ricardoalcaraz/TheJerrys/README.md

# The Jerrys Micromouse Team
*******************************************
Code for solving 16x16 maze using floodfill algorithm on Tensilica architecture.
