ricardoalcaraz/TheJerrys/(list of files, drawings)

Other design files:
altium_v4/altium_v4.PrjPCB
altium_v4/Communications.SchDoc
altium_v4/MCU.SchDoc
altium_v4/Micromouse_Altium_v4.PcbDoc
altium_v4/Micromouse_Altium_v4.SchDoc
altium_v4/Motors.SchDoc
altium_v4/Power.SchDoc
altium_v4/Sensors.SchDoc
