ricardoalcaraz/TheJerrys/eagle_v1/micromouse_v35.brd

## EAGLE design eagle_v1/micromouse_v35.brd (2017-06-12, an earlier design)

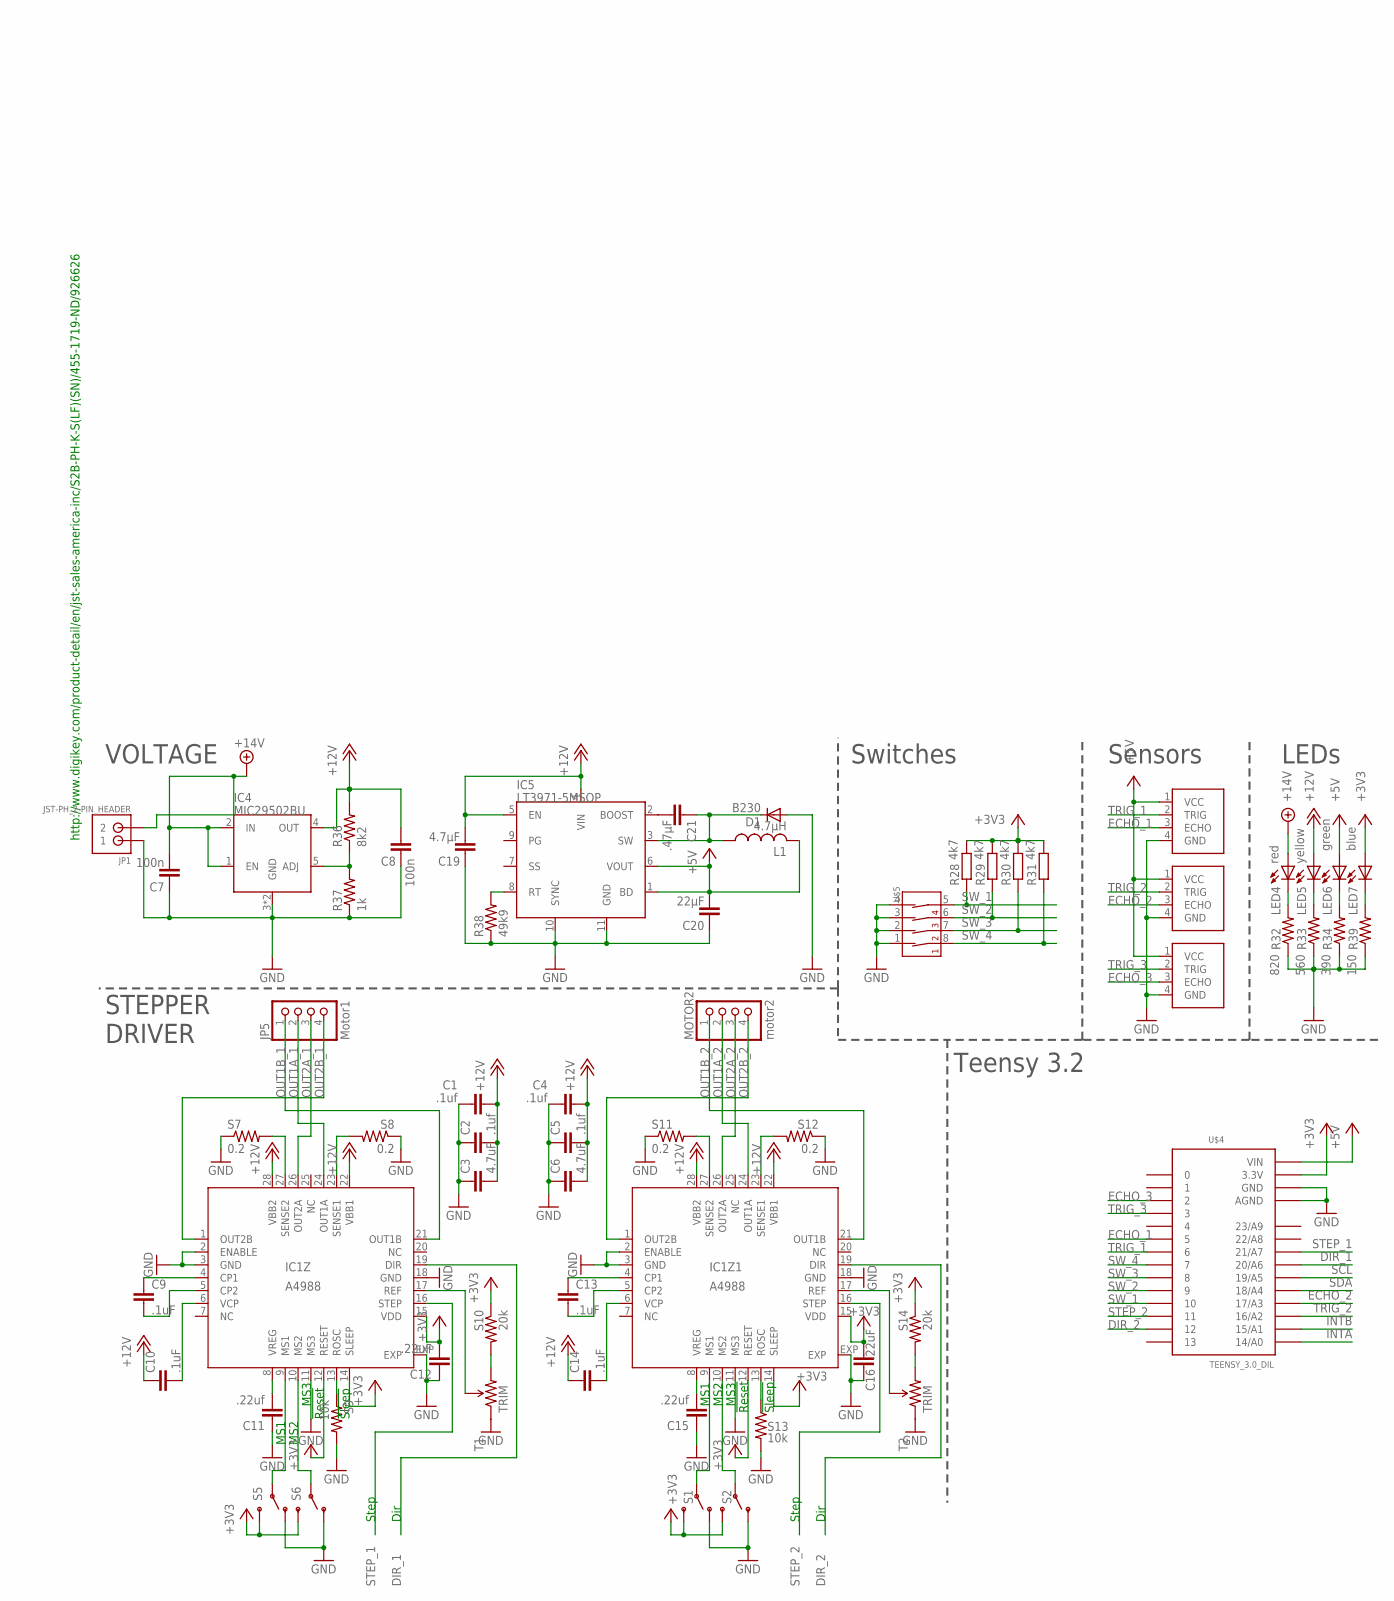
[picture p1: schematic micromouse_v35.sch]

Parts:
C1, C2, C4, C5: .1uf; C0603
C3, C6: 4.7uF; 1206
C7, C8: 100n; C0603
C9, C10, C13, C14: .1uF; C0603
C11, C15: .22uf; C0603
C12, C16: .22uF; C0603
C19: 4.7µF; C0603
C20: 22µF; C0805
C21: .47µF; C0603
D1: B230; DO-214AC
IC1Z, IC1Z1: A4988; QFN28ET
IC4: MIC29502BU; TO-263-5
IC5: LT3971-5MSOP; MSOP-10
JP1: JST-PH_2-PIN_HEADER; JST_B2B-PH_HEADER
JP5: Motor1; 1X04
L1: 4.7µH; L1812
LED4: red; SML0603
LED5: yellow; SML0603
LED6: green; SML0603
LED7: blue; SML0603
MOTOR2: motor2; 1X04
R28, R29, R30, R31: 4k7; R0603
R32: 820; R0603
R33: 560; R0603
R34: 390; R0603
R36: 8k2; R0603
R37: 1k; R0603
R38: 49k9; R0603
R39: 150; R0603
S1, S2, S5, S6: SWITCH-SPDT-SMD-A; SWITCH-SPST-SMD-A
S7, S8, S11, S12: 0.2; R0603
S9, S13: 10k; R0603
S10, S14: 20k; R0603
SENSOR1, SENSOR2, SENSOR3: HC-SR04SMD; HC-SR04_SMD
T1, T2: TRIM; TRIMPOT-3MM
U$4: TEENSY_3.0_DIL; TEENSY3-DIL
U$5: 4-POS-DIP; 4-POS-DIP-SMD

Connections:
+3V3: C12.2, C16.2, IC1Z.12 (RESET), IC1Z.14 (SLEEP), IC1Z.15 (VDD), IC1Z1.12 (RESET), IC1Z1.14 (SLEEP), IC1Z1.15 (VDD), LED7.A, R28.2, R29.2, R30.2, R31.2, S1.3 (S), S2.3 (S), S5.3 (S), S6.3 (S), S10.1, S14.1, U$4.3.3V
+5V: C20.2, IC5.1 (BD), IC5.6 (VOUT), L1.2, LED6.A, SENSOR1.1 (VCC), SENSOR2.1 (VCC), SENSOR3.1 (VCC), U$4.VIN
+12V: C1.2, C2.2, C3.2, C4.2, C5.2, C6.2, C8.2, C10.1, C14.1, C19.2, IC1Z.22 (VBB1), IC1Z.28 (VBB2), IC1Z1.22 (VBB1), IC1Z1.28 (VBB2), IC4.4 (OUT), IC5.4 (VIN), IC5.5 (EN), LED5.A, R36.2
+14V: C7.2, IC4.1 (EN), IC4.2 (IN), JP1.P2 (2), LED4.A
DIR_1: IC1Z.19 (DIR), U$4.20/A6
DIR_2: IC1Z1.19 (DIR), U$4.12
ECHO_1: SENSOR1.3 (ECHO), U$4.5
ECHO_2: SENSOR2.3 (ECHO), U$4.17/A3
ECHO_3: SENSOR3.3 (ECHO), U$4.2
GND: C1.1, C2.1, C3.1, C4.1, C5.1, C6.1, C7.1, C8.1, C11.1, C12.1, C15.1, C16.1, C19.1, C20.1, D1.A, IC1Z.2 (ENABLE), IC1Z.3 (GND), IC1Z.11 (MS3), IC1Z.18 (GND), IC1Z.EXP, IC1Z1.2 (ENABLE), IC1Z1.3 (GND), IC1Z1.11 (MS3), IC1Z1.18 (GND), IC1Z1.EXP, IC4.3 (GND), IC4.6 (GND), IC5.10 (SYNC), IC5.11 (GND), JP1.P1 (1), R32.1, R33.1, R34.1, R37.1, R38.1, R39.1, S1.1 (O), S2.1 (O), S5.1 (O), S6.1 (O), S7.1, S8.1, S9.2, S11.1, S12.1, S13.2, SENSOR1.4 (GND), SENSOR2.4 (GND), SENSOR3.4 (GND), T1.1 (CCW), T2.1 (CCW), U$4.AGND, U$4.GND, U$5.1 (1A), U$5.2 (2A), U$5.3 (3A), U$5.4 (4A)
INTA: U$4.14/A0
INTB: U$4.15/A1
unnamed: LED4.C, R32.2
unnamed: LED5.C, R33.2
unnamed: LED6.C, R34.2
unnamed: IC4.5 (ADJ), R36.1, R37.2
unnamed: IC5.8 (RT), R38.2
unnamed: C21.2, IC5.2 (BOOST)
unnamed: C21.1, D1.C, IC5.3 (SW), L1.1
unnamed: LED7.C, R39.2
OUT1A_1: IC1Z.24 (OUT1A), JP5.2
OUT1A_2: IC1Z1.24 (OUT1A), MOTOR2.2
OUT1B_1: IC1Z.21 (OUT1B), JP5.1
OUT1B_2: IC1Z1.21 (OUT1B), MOTOR2.1
OUT2A_1: IC1Z.26 (OUT2A), JP5.3
OUT2A_2: IC1Z1.26 (OUT2A), MOTOR2.3
OUT2B_1: IC1Z.1 (OUT2B), JP5.4
OUT2B_2: IC1Z1.1 (OUT2B), MOTOR2.4
SCL: U$4.19/A5
SDA: U$4.18/A4
STEP_1: IC1Z.16 (STEP), U$4.21/A7
STEP_2: IC1Z1.16 (STEP), U$4.11
SW_1: R28.1, U$4.10, U$5.5 (4B)
SW_2: R29.1, U$4.9, U$5.6 (3B)
SW_3: R30.1, U$4.8, U$5.7 (2B)
SW_4: R31.1, U$4.7, U$5.8 (1B)
TRIG_1: SENSOR1.2 (TRIG), U$4.6
TRIG_2: SENSOR2.2 (TRIG), U$4.16/A2
TRIG_3: SENSOR3.2 (TRIG), U$4.3
ZCP1: C9.1, IC1Z.4 (CP1)
ZCP2: C9.2, IC1Z.5 (CP2)
ZCP3: C13.1, IC1Z1.4 (CP1)
ZCP4: C13.2, IC1Z1.5 (CP2)
ZMS1: IC1Z.9 (MS1), S5.2
ZMS2: IC1Z.10 (MS2), S6.2
ZMS3: IC1Z1.9 (MS1), S1.2
ZMS4: IC1Z1.10 (MS2), S2.2
ZREF: IC1Z.17 (REF), T1.2 (WIPER)
ZREF1: IC1Z1.17 (REF), T2.2 (WIPER)
ZREF2: S10.2, T1.3 (CW)
ZREF3: S14.2, T2.3 (CW)
ZROSC: IC1Z.13 (ROSC), S9.1
ZROSC1: IC1Z1.13 (ROSC), S13.1
ZSENSE1: IC1Z.23 (SENSE1), S8.2
ZSENSE2: IC1Z.27 (SENSE2), S7.2
ZSENSE3: IC1Z1.27 (SENSE2), S11.2
ZSENSE4: IC1Z1.23 (SENSE1), S12.2
ZVCP: C10.2, IC1Z.6 (VCP)
ZVCP1: C14.2, IC1Z1.6 (VCP)
ZVREG: C11.2, IC1Z.8 (VREG)
ZVREG1: C15.2, IC1Z1.8 (VREG)

Notes on the sheet:
MS3
!Reset
!Sleep
MS1
MS2
Step
Dir
VOLTAGE
STEPPER DRIVER
LEDs
Teensy 3.2
Sensors
Switches
http://www.digikey.com/product-detail/en/jst-sales-america-inc/S2B-PH-K-S(LF)(SN)/455-1719-ND/926626

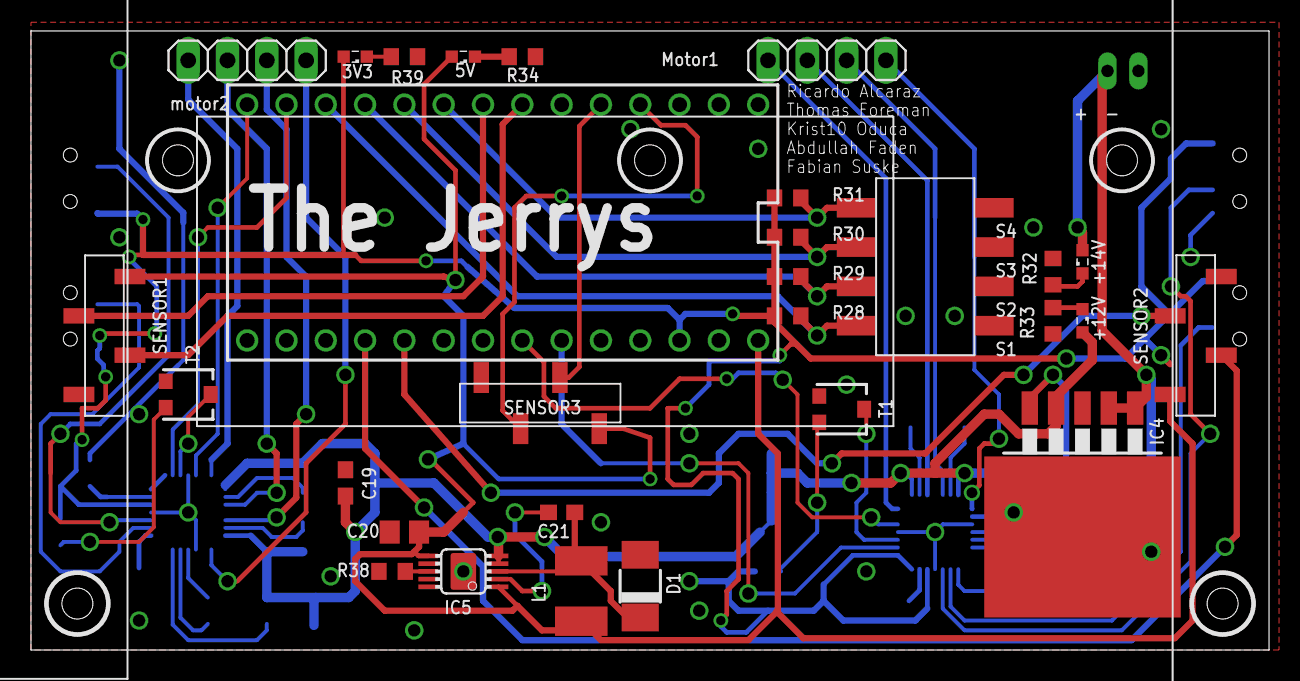
[picture p2: board micromouse_v35.brd from above]

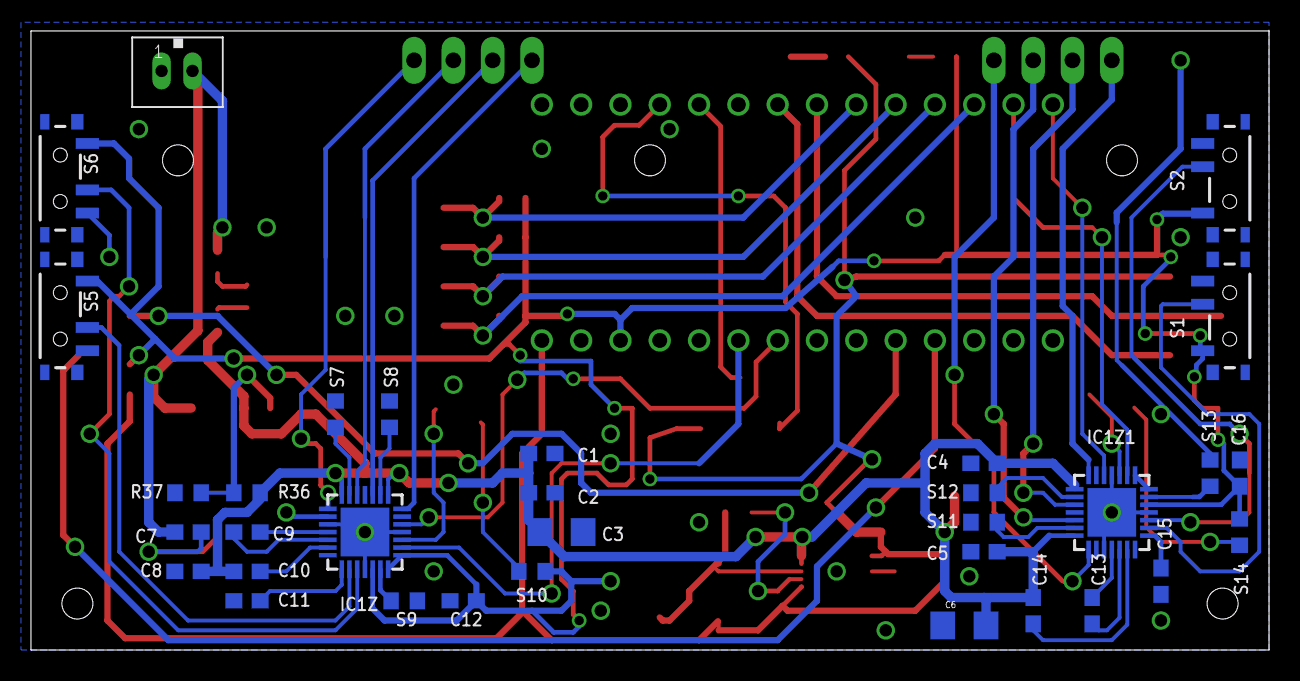
[picture p3: board micromouse_v35.brd from below]

Board: 2 copper layers, 80.0 x 40.0 mm, 62 parts (33 on the bottom side), 57 nets.
