ricardoalcaraz/TheJerrys/eagle_v2/boardv2.brd

## EAGLE design eagle_v2/boardv2.brd (2018-06-07, an earlier design)

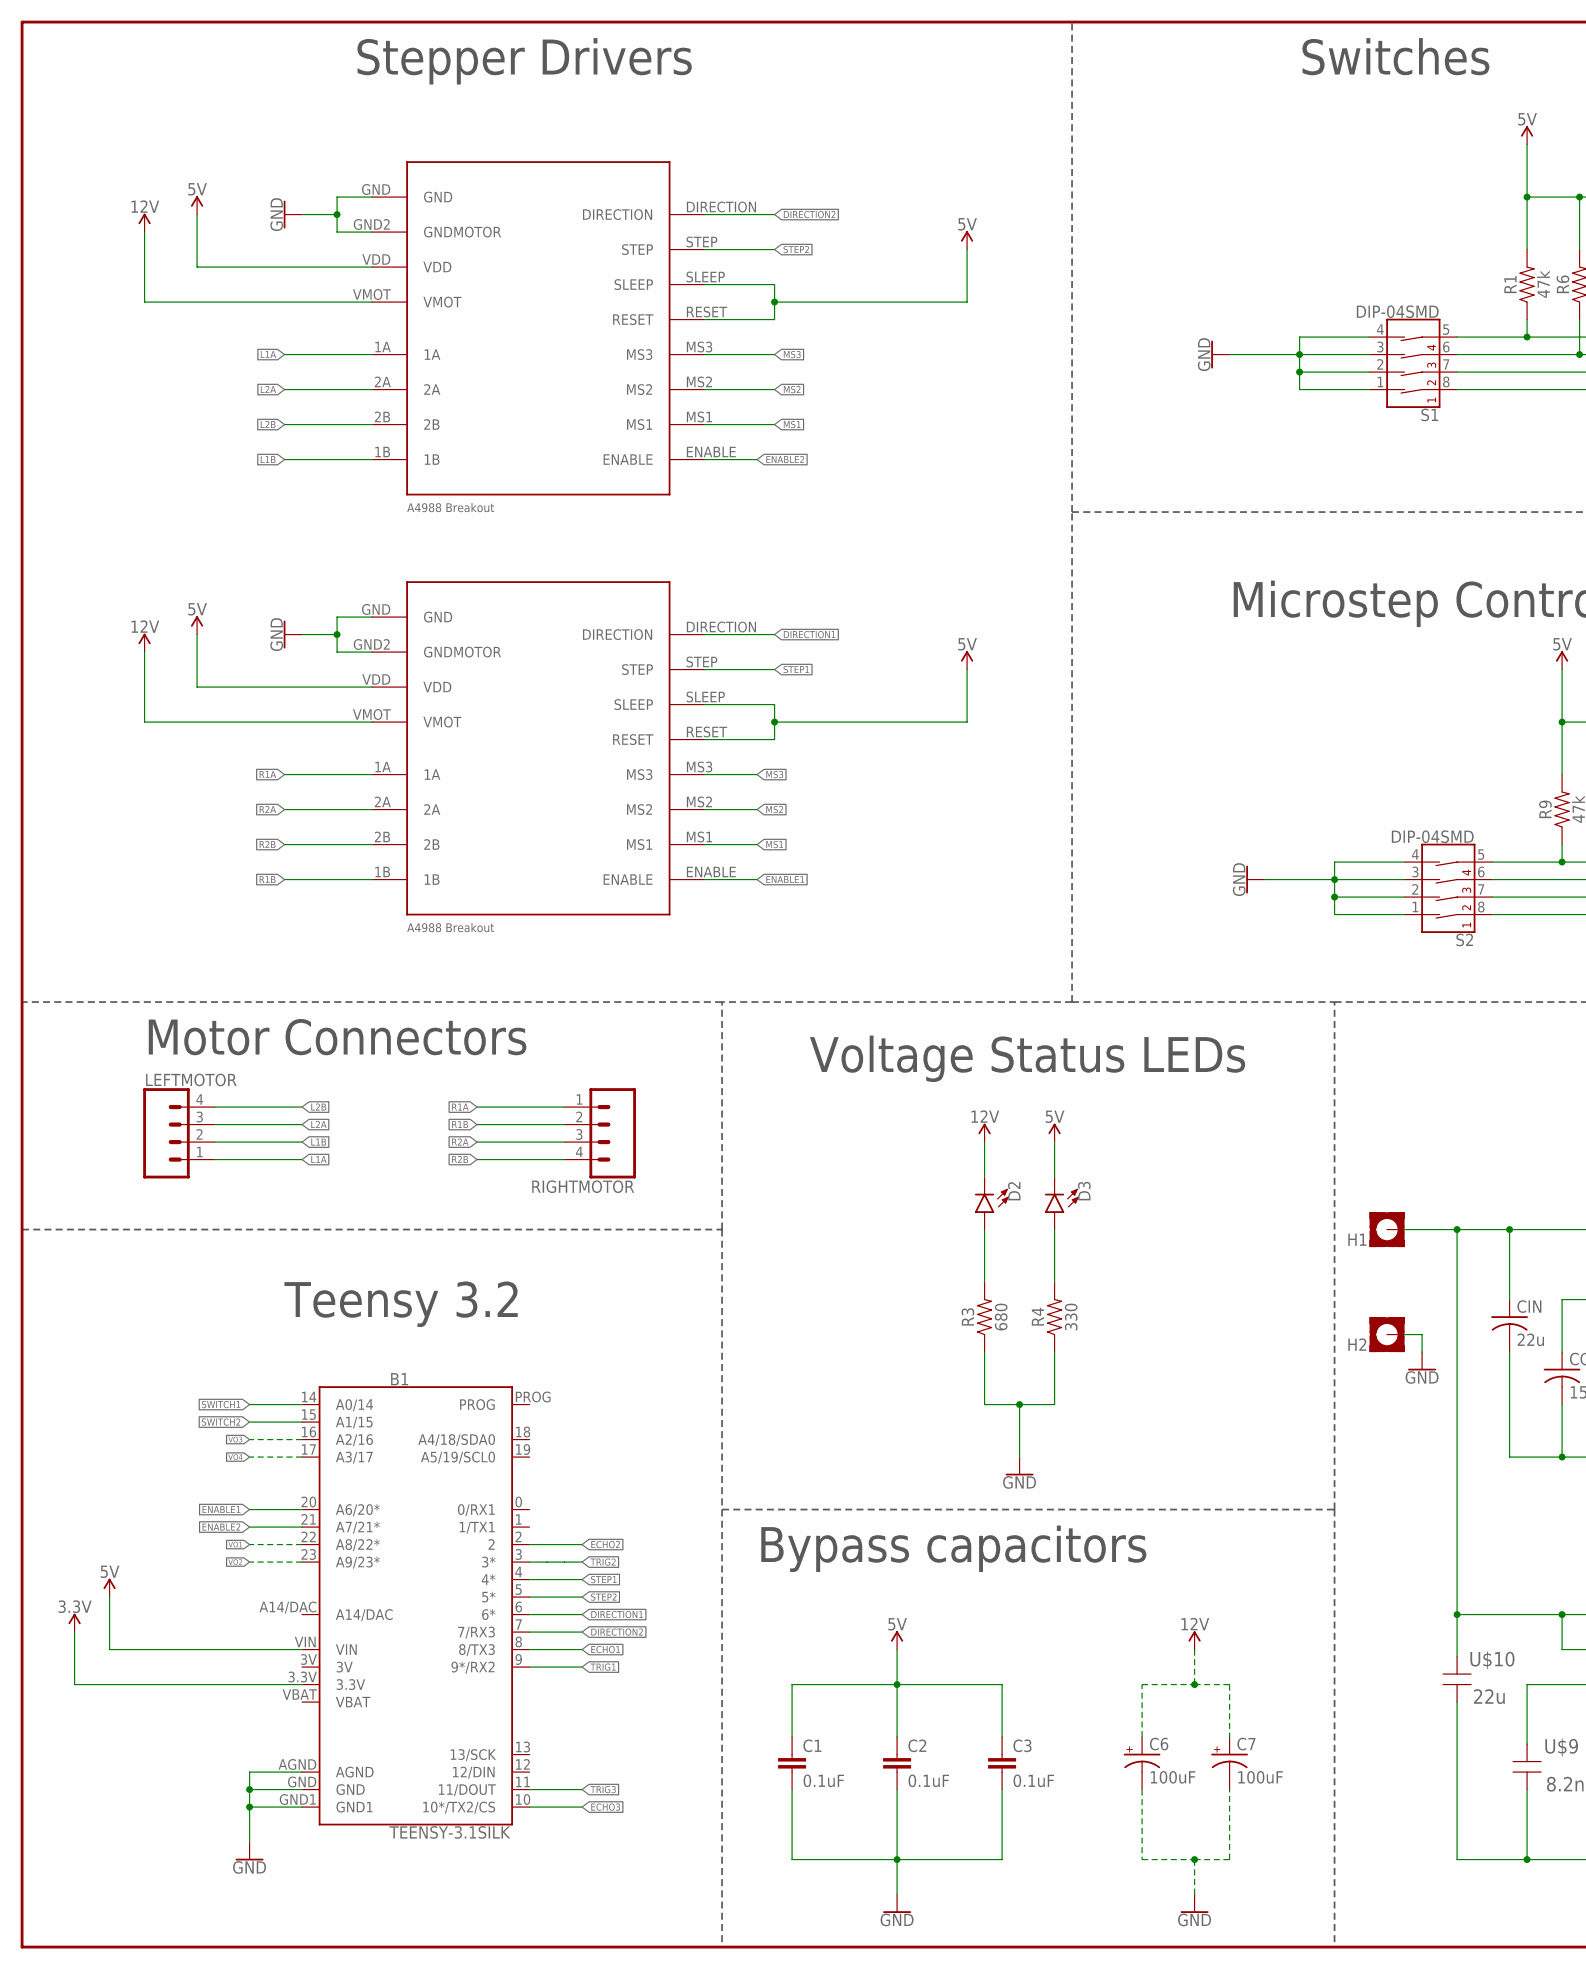
[picture p4: schematic boardv2.sch, part in row 1, column 1]

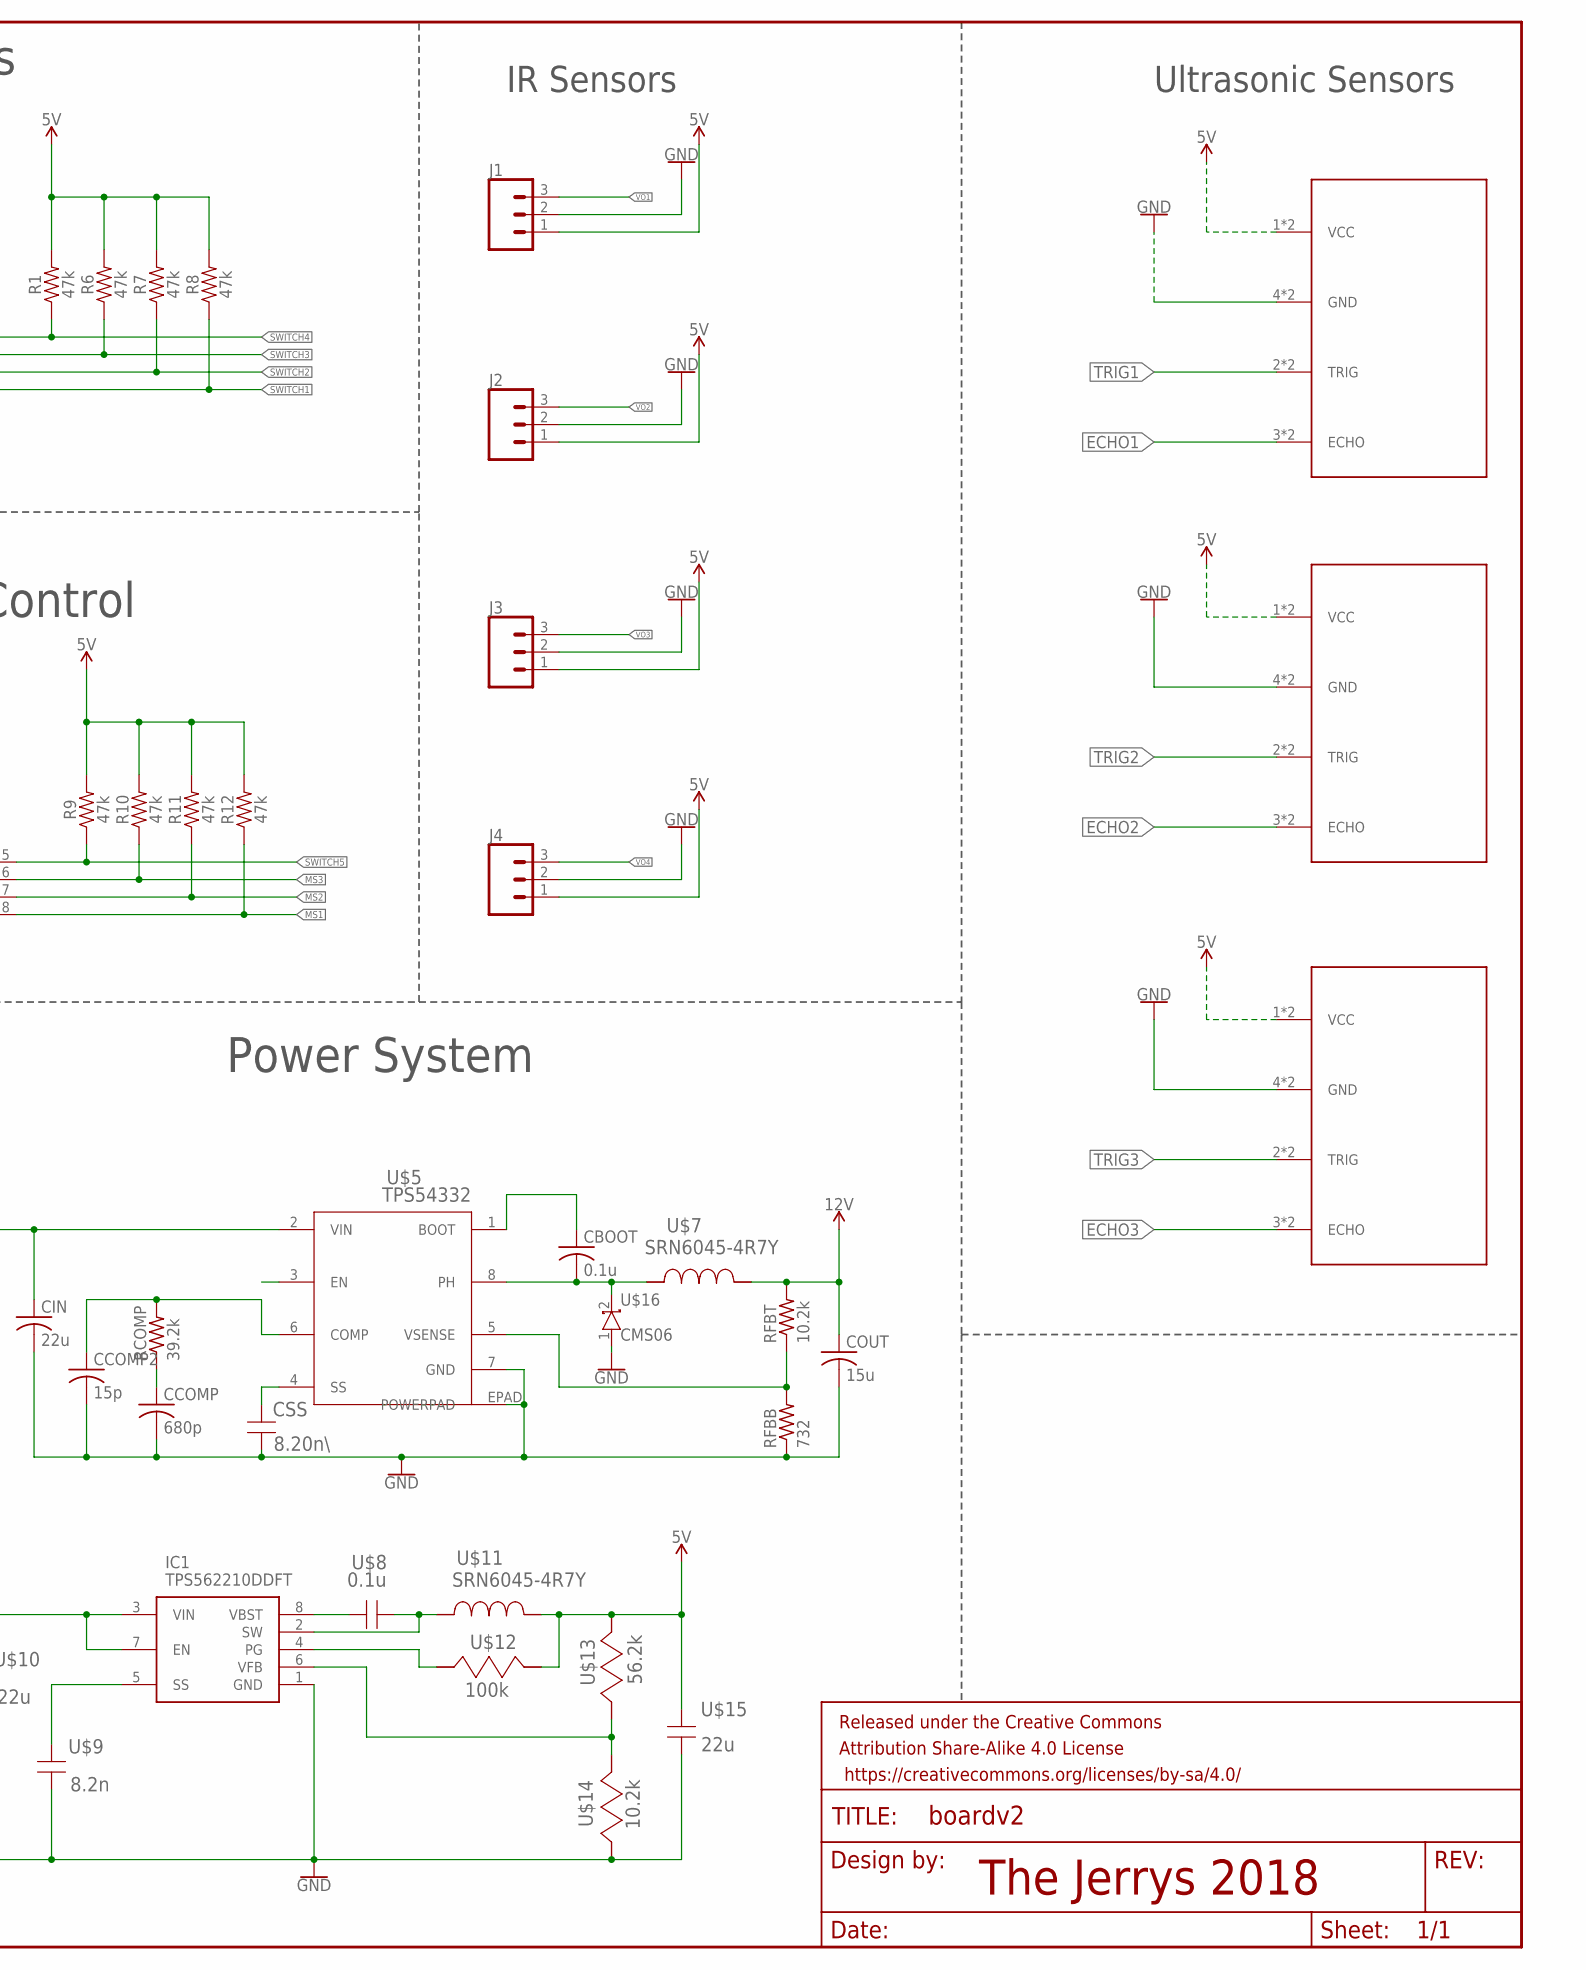
[picture p5: schematic boardv2.sch, part in row 1, column 2]

Parts:
B1: TEENSY-3.1SILK; TEENSY-3.1
C1, C2, C3: 0.1uF; 0603
C6, C7: 100uF; PANASONIC_D
CBOOT: 0.1u; C0805
CCOMP: 680p; C0805
CCOMP2: 15p; C0805
CIN: 22u; C1210
COUT: 15u; C0805
CSS: 8.20n\; 1206
D2, D3: LED0603; LED-0603
FRAME1: FRAME-LEDGER; CREATIVE_COMMONS
H1, H2: MOUNT-PAD-SQUARE2.8; 2,8-PAD-SQUARE
IC1: TPS562210DDFT; SOT65P280X110-8N
J1, J2, J3, J4: CONN_03JST-PTH-VERT; JST-3-PTH-VERT
LEFTMOTOR: CONN_04LONGPADS; 1X04_LONGPADS
R1, R6, R7, R8, R9, R10, R11, R12: 47k; 0603
R3: 680; 0603
R4: 330; 0603
RCOMP: 39.2k; R0805
RFBB: 732; R0805
RFBT: 10.2k; R0805
RIGHTMOTOR: CONN_04LONGPADS; 1X04_LONGPADS
S1, S2: DIP-04SMD; DIPSWITCH-04-SMD
U$1, U$2: A4988_BREAKOUT
U$3, U$4, U$6: ULTRASONIC; 1X04_SMD_VERTICAL_COMBO
U$5: TPS54332; DDA8_2P13X3-M
U$7, U$11: SRN6045-4R7Y; SRN6045
U$8: 0.1u; 0805
U$9: 8.2n; 1206
U$10: 22u; 1210
U$12: 100k; 0805
U$13: 56.2k; 0805
U$14: 10.2k; 0805
U$15: 22u; 1206_190
U$16: CMS06; SODFL4724X108N

Connections:
3.3V: B1.3.3V
3V: B1.3V
5V: B1.VIN, C1.1, C2.1, C3.1, D3.C, J1.1, J2.1, J3.1, J4.1, R1.2, R6.2, R7.2, R8.2, R9.2, R10.2, R11.2, R12.2, U$1.RESET, U$1.SLEEP, U$1.VDD, U$2.RESET, U$2.SLEEP, U$2.VDD, U$3.1 (VCC), U$3.1-2 (VCC), U$4.1 (VCC), U$4.1-2 (VCC), U$6.1 (VCC), U$6.1-2 (VCC), U$11.2, U$12.1, U$13.1, U$15.1
12V: C6.+, C7.+, COUT.1, D2.C, RFBT.2, U$1.VMOT, U$2.VMOT, U$7.2
BOOT: IC1.2 (SW), U$8.1, U$11.1
DIRECTION1: B1.6 (6*), U$2.DIRECTION
DIRECTION2: B1.7 (7/RX3), U$1.DIRECTION
ECHO1: B1.8 (8/TX3), U$3.3 (ECHO), U$3.3-2 (ECHO)
ECHO2: B1.2, U$4.3 (ECHO), U$4.3-2 (ECHO)
ECHO3: B1.10 (10*/TX2/CS), U$6.3 (ECHO), U$6.3-2 (ECHO)
ENABLE1: B1.20 (A6/20*), U$2.ENABLE
ENABLE2: B1.21 (A7/21*), U$1.ENABLE
GND: B1.AGND, B1.GND, B1.GND1, C1.2, C2.2, C3.2, C6.-, C7.-, CCOMP.2, CCOMP2.2, CIN.2, COUT.2, CSS.1, H2.B2,8, IC1.1 (GND), J1.2, J2.2, J3.2, J4.2, R3.1, R4.1, RFBB.1, S1.1 (1A), S1.2 (2A), S1.3 (3A), S1.4 (4A), S2.1 (1A), S2.2 (2A), S2.3 (3A), S2.4 (4A), U$1.GND, U$1.GND2 (GNDMOTOR), U$2.GND, U$2.GND2 (GNDMOTOR), U$3.4 (GND), U$3.4-2 (GND), U$4.4 (GND), U$4.4-2 (GND), U$5.7 (GND), U$5.EPAD (POWERPAD), U$6.4 (GND), U$6.4-2 (GND), U$9.2, U$10.2, U$14.2, U$15.2, U$16.1 (A)
L1A: LEFTMOTOR.1, U$1.1A
L1B: LEFTMOTOR.2, U$1.1B
L2A: LEFTMOTOR.3, U$1.2A
L2B: LEFTMOTOR.4, U$1.2B
MS1: R12.1, S2.8 (1B), U$1.MS1, U$2.MS1
MS2: R11.1, S2.7 (2B), U$1.MS2, U$2.MS2
MS3: R10.1, S2.6 (3B), U$1.MS3, U$2.MS3
unnamed: D2.A, R3.2
unnamed: D3.A, R4.2
unnamed: CSS.2, U$5.4 (SS)
unnamed: IC1.8 (VBST), U$8.2
unnamed: RFBB.2, RFBT.1, U$5.5 (VSENSE)
unnamed: CBOOT.1, U$5.1 (BOOT)
unnamed: CCOMP2.1, RCOMP.2, U$5.6 (COMP)
unnamed: CCOMP.1, RCOMP.1
unnamed: IC1.4 (PG), U$12.2
unnamed: IC1.6 (VFB), U$13.2, U$14.1
unnamed: IC1.5 (SS), U$9.1
PH: CBOOT.2, U$5.8 (PH), U$7.1, U$16.2 (K)
R1A: RIGHTMOTOR.1, U$2.1A
R1B: RIGHTMOTOR.2, U$2.1B
R2A: RIGHTMOTOR.3, U$2.2A
R2B: RIGHTMOTOR.4, U$2.2B
STEP1: B1.4 (4*), U$2.STEP
STEP2: B1.5 (5*), U$1.STEP
SWITCH1: B1.14 (A0/14), R8.1, S1.8 (1B)
SWITCH2: B1.15 (A1/15), R7.1, S1.7 (2B)
SWITCH3: R6.1, S1.6 (3B)
SWITCH4: R1.1, S1.5 (4B)
SWITCH5: R9.1, S2.5 (4B)
TRIG1: B1.9 (9*/RX2), U$3.2 (TRIG), U$3.2-2 (TRIG)
TRIG2: B1.3 (3*), U$4.2 (TRIG), U$4.2-2 (TRIG)
TRIG3: B1.11 (11/DOUT), U$6.2 (TRIG), U$6.2-2 (TRIG)
VBAT: B1.VBAT
VIN: CIN.1, H1.B2,8, IC1.3 (VIN), IC1.7 (EN), U$5.2 (VIN), U$10.1
VO1: B1.22 (A8/22*), J1.3
VO2: B1.23 (A9/23*), J2.3
VO3: B1.16 (A2/16), J3.3
VO4: B1.17 (A3/17), J4.3

Notes on the sheet:
Stepper Drivers
Teensy 3.2
Switches
Microstep Control
Motor Connectors
Voltage Status LEDs
Bypass capacitors
The Jerrys 2018
IR Sensors
Ultrasonic Sensors
Power System

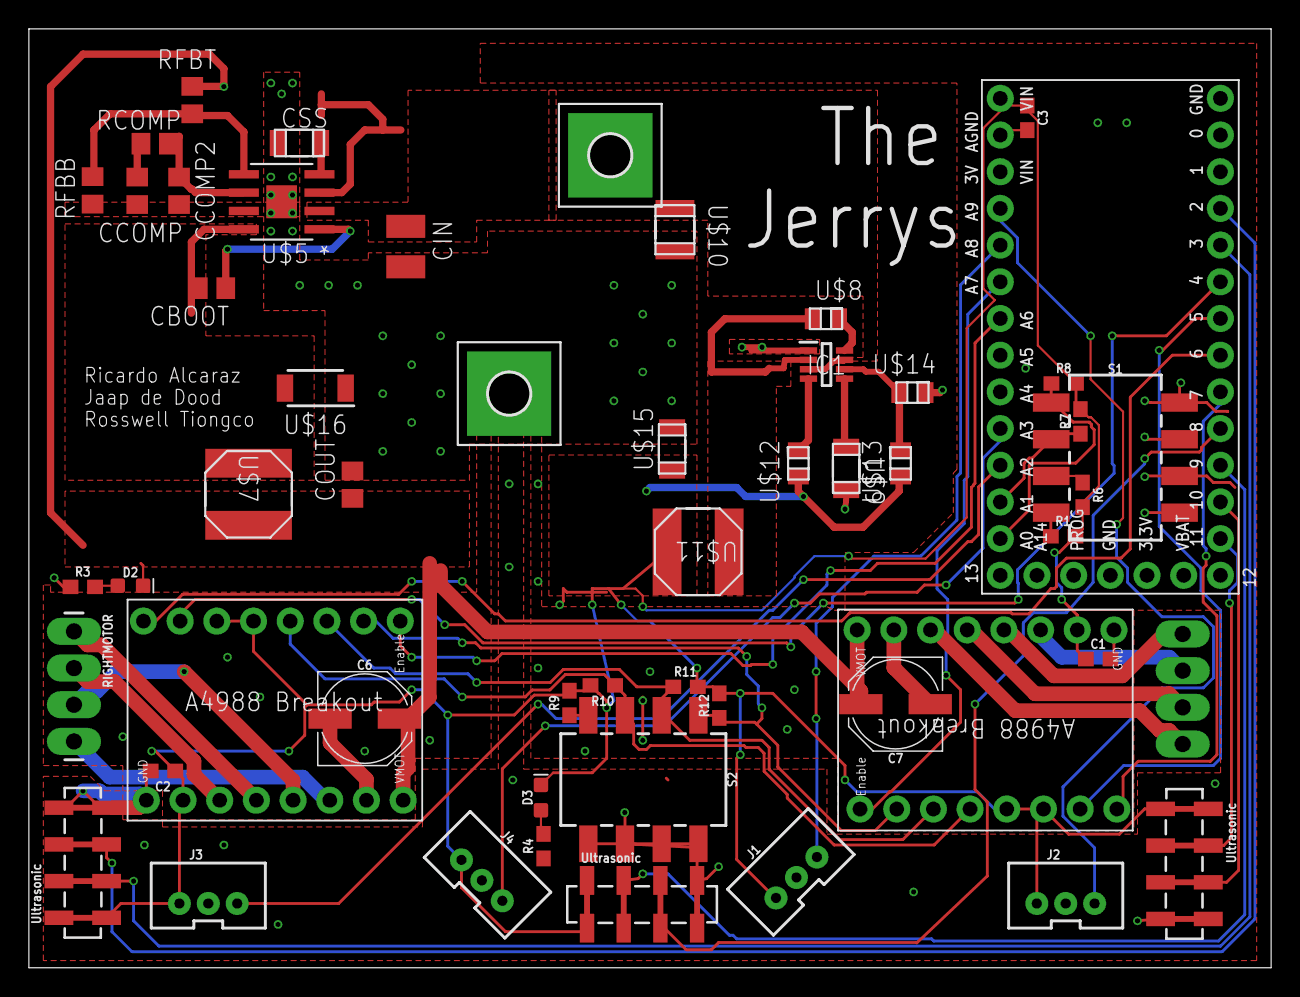
[picture p6: board boardv2.brd from above]

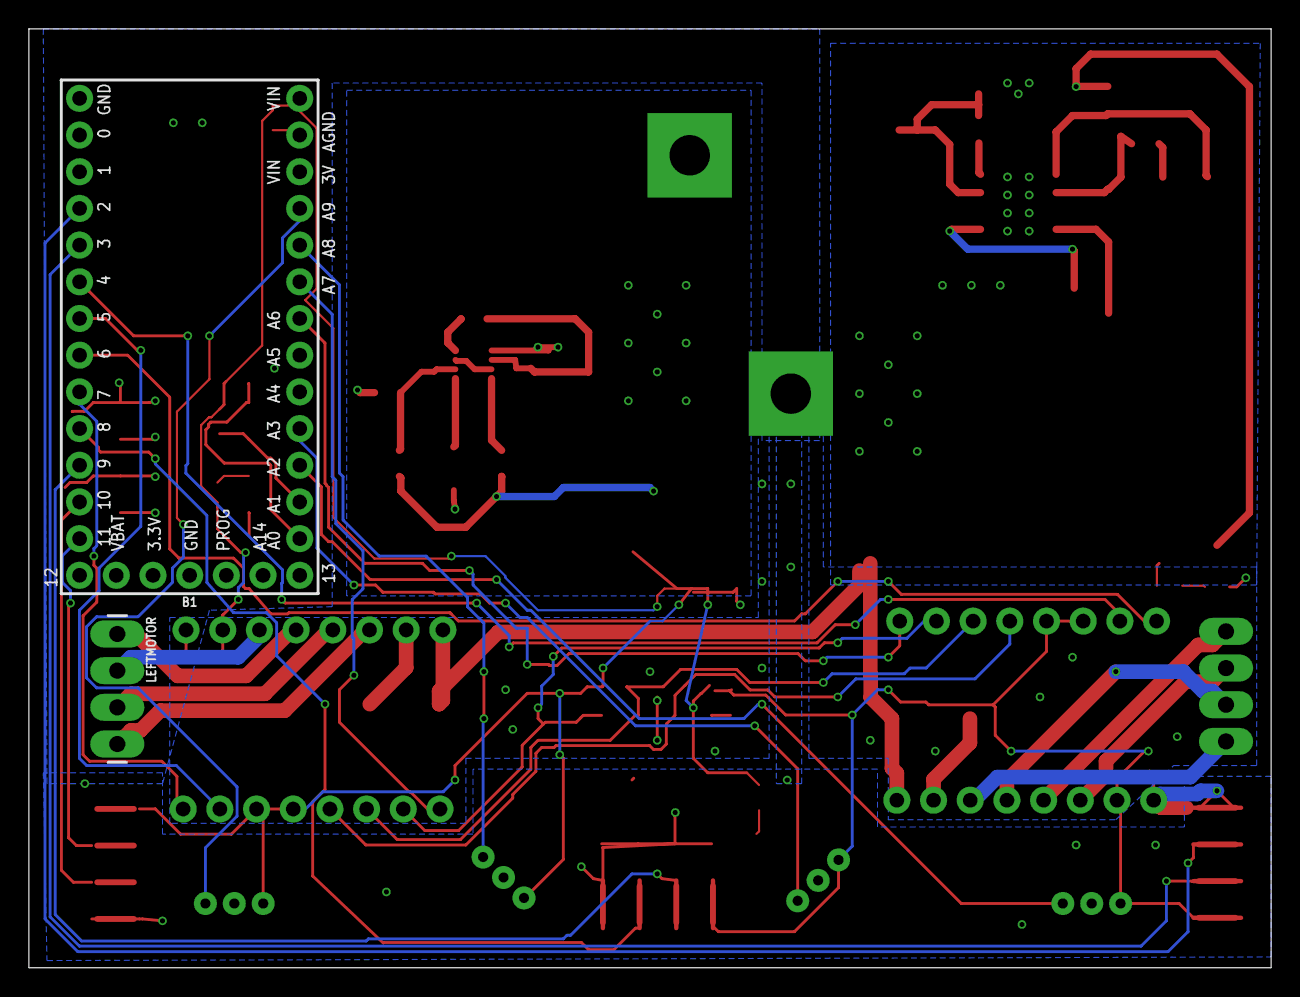
[picture p7: board boardv2.brd from below]

Board: 2 copper layers, 86.0 x 65.0 mm, 55 parts (2 on the bottom side), 49 nets.
