ricardoalcaraz/TheJerrys/eagle_v3/boardv3.brd

## EAGLE design eagle_v3/boardv3.brd (2018-07-19)

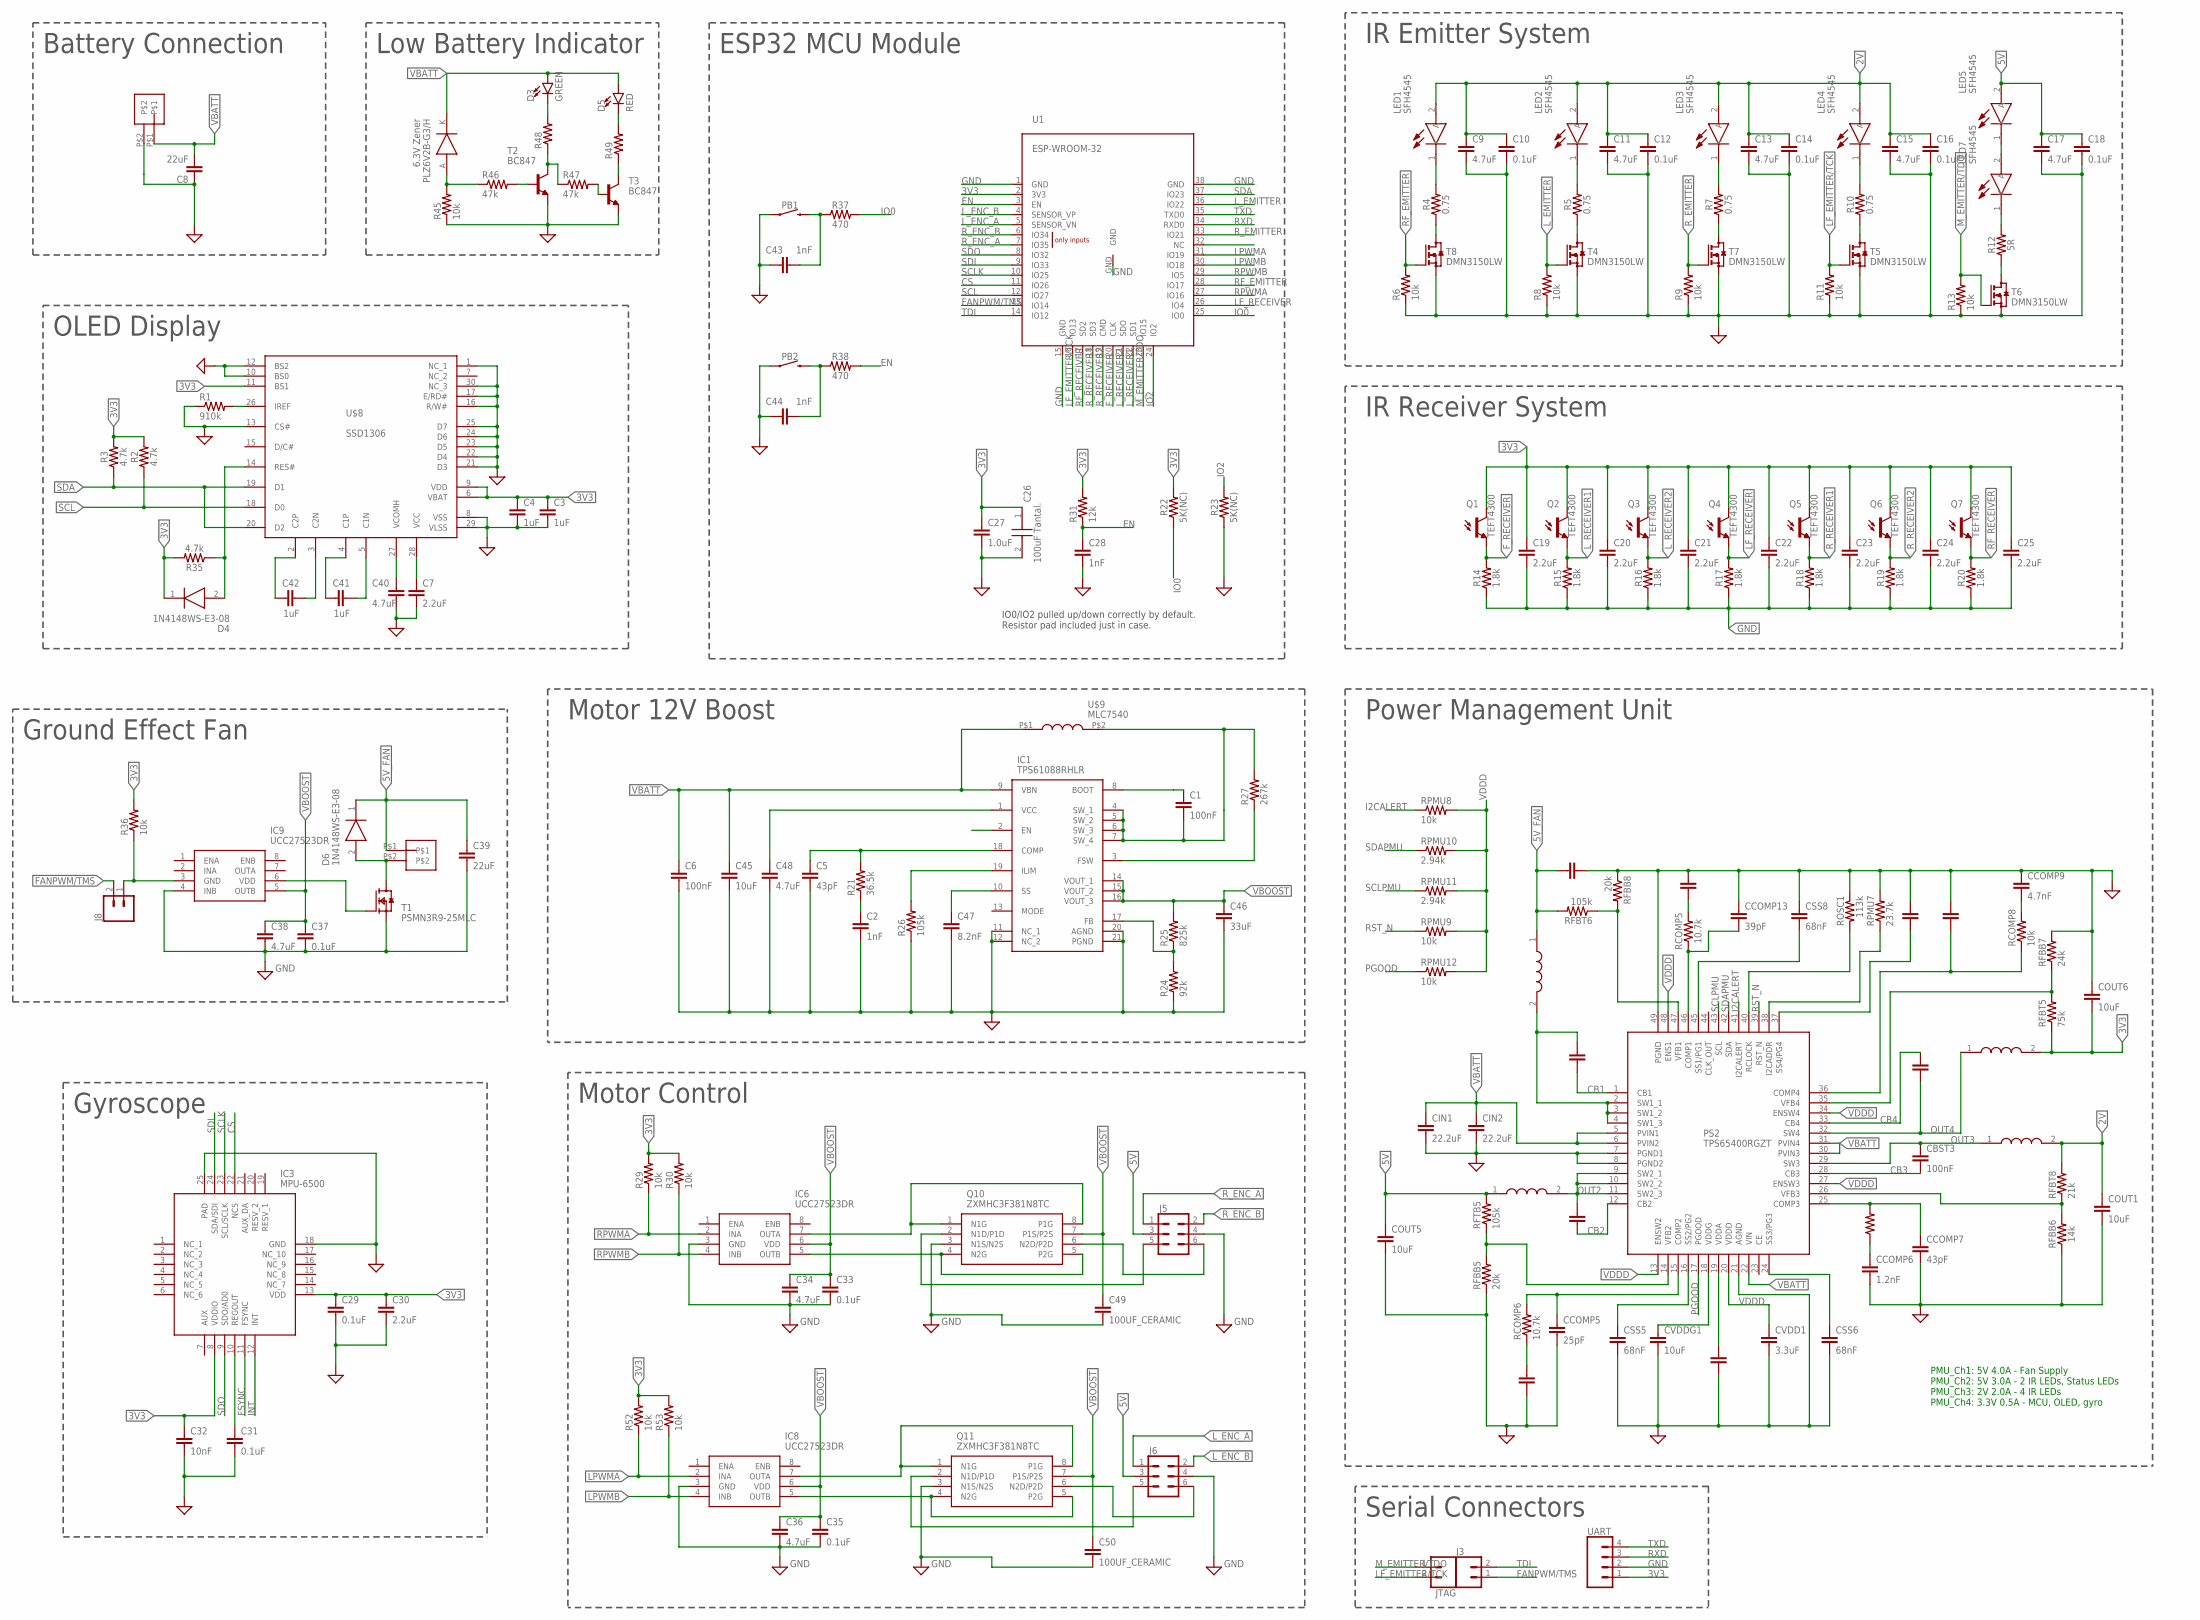
[picture p8: schematic boardv3.sch, sheet 1]

Parts:
C1: 100nF; C0402
C2: 1nF; C0805
C3, C4, C41, C42: 1uF; C0402
C5: 43pF; C0402
C6: 100nF; C0805
C7: 2.2uF; C0402
C8, C39: 22uF; 0805
C9, C11, C13, C15, C17, C34, C36, C38: 4.7uF; 0603
C10, C12, C14, C16, C18: 0.1uF; C0402
C19, C20, C21, C22, C23, C24, C25, C30: 2.2uF; 0603
C26: 100uF Tantal.; CAPPM3528X210N
C27: 1.0uF; 0402
C28, C43, C44: 1nF; 0603
C29, C31, C33, C35, C37: 0.1uF; 0603
C32: 10nF; 0603
C40, C48: 4.7uF; C0402
C45: 10uF; C0402
C46: 33uF; C1206
C47: 8.2nF; C0805
C49, C50: 100UF_CERAMIC; C1210
CBST1, CBST2, CBST3, CBST4: 100nF; C0402
CCOMP5: 25pF; C0603
CCOMP6, CCOMP11: 1.2nF; C0603
CCOMP7: 43pF; C0603
CCOMP8: 1.8nF; C0603
CCOMP9: 4.7nF; C0603
CCOMP10: 82pF; C0603
CCOMP13: 39pF; C0603
CIN1, CIN2, CIN3: 22.2uF; 0805
COUT1, COUT5, COUT6: 10uF; C0402
CSS5, CSS6, CSS7, CSS8: 68nF; C0402
CVDD1: 3.3uF; C0402
CVDDA1: 4.7uF; 0603
CVDDG1: 10uF; C0603
D3: GREEN; LED-0603
D4, D6: 1N4148WS-E3-08; SOD2713X115N
D5: RED; LED-0603
IC1: TPS61088RHLR; RHL(R-PVQFN-N20)_1
IC3: MPU-6500; QFN40P300X300X95-25N
IC6, IC8, IC9: UCC27523DR; SOIC127P600X175-8N
J2, J7: 2_PIN_JST-XH
J3, J8: CONN_02; 1X02
J5, J6: CONN_03X22X3_SILK_MALE_PTH; 2X3
JTAG: CONN_02; 1X02
L5: XAL4030-332MEB
L6: SDR0302-100ML; SDR0302-471KL
L7: XAL4030-472MEB; XAL4030-332MEB
L8: XFL4020-472MEB; XFL4020-222ME
LED1, LED2, LED3, LED4, LED5, LED7: SFH4545; SFH_4556P
PB1, PB2: SPST_3X6X2.5MMPB; 3X6X2.5MMSPB
PLZ6V2B-G3/H: 6.3V Zener; DO-219AC
PS2: TPS65400RGZT; QFN50P700X700X100-49N
Q1, Q2, Q3, Q4, Q5, Q6, Q7: TEFT4300
Q10, Q11: ZXMHC3F381N8TC; SOIC127P600X175-8N
R1: 910k; R0402
R2, R3, R35: 4.7k; 0603
R4, R5, R7, R10: 0.75; 0805
R6, R8, R9, R11, R13, R29, R30, R36, R52, R53: 10k; R0201
R12: 5R; 0805
R14, R15, R16, R17, R18, R19, R20: 1.8k; 0603
R21: 36.5k; R0201
R22, R23: 5K(NC); 0402
R24: 92k; R0805
R25: 825k; R0402
R26: 105k; R0201
R27: 267k; R0402
R31: 12k; R0201
R37, R38: 470; 0603
R45: 10k; R0402
R46, R47: 47k; R0402
R48, R49: R-US_R0603; R0603
RCOMP5: 10.7k; 0402
RCOMP6: 10.7k; R0402
RCOMP7: 9.31k; R0402
RCOMP8: 10k; R0201
RFBB5, RFBB8: 20k; R0805
RFBB6: 14k; 0402
RFBB7: 24k; R0805
RFBT5: 75k; R0402
RFBT6: 105k; R0201
RFBT8: 21k; R0402
RFTB5: 105k; R0201
ROSC1: 113k; R0402
RPMU7: 23.7k; R0201
RPMU8, RPMU9, RPMU12: 10k; R0201
RPMU10, RPMU11: 2.94k; R0402
T1: PSMN3R9-25MLC; SOT1210
T2, T3: BC847; SOT23
T4, T5, T6, T7, T8: DMN3150LW; SOT323
U1: ESP-WROOM-32
U$8: SSD1306; 30PINFPC_P0.7MM
U$9: MLC7540
UART: CONN_04; 1X04

Connections:
2V: C9.1, C10.1, C11.1, C12.1, C13.1, C14.1, C15.1, C16.1, COUT1.1, L8.2, LED1.2 (A), LED2.2 (A), LED3.2 (A), LED4.2 (A), RFBT8.2
3V3: C3.1, C4.1, C19.1, C20.1, C21.1, C22.1, C23.1, C24.1, C25.1, C26.1, C27.1, C29.1, C30.1, C32.1, COUT6.2, D4.1 (K), IC3.8 (VDDIO), IC3.13 (VDD), L6.2, Q1.1 (C), Q2.1 (C), Q3.1 (C), Q4.1 (C), Q5.1 (C), Q6.1 (C), Q7.1 (C), R2.2, R3.2, R22.2, R29.2, R30.2, R31.2, R35.2, R36.2, R52.2, R53.2, RFBT5.1, U1.2 (3V3), U$8.6 (VBAT), U$8.9 (VDD), U$8.11 (BS1), UART.1
5V: C17.1, C18.1, COUT5.1, J5.3, J6.3, L5.1, LED5.2 (A), RFTB5.2
5V_FAN: C39.1, CIN3.1, D6.1 (K), J7.P$1, L7.1, RFBT6.2
BOOSTEN: IC1.2 (EN)
CB1: CBST1.1, PS2.1 (CB1)
CB2: CBST2.1, PS2.12 (CB2)
CB3: CBST3.2, PS2.28 (CB3)
CB4: CBST4.2, PS2.33 (CB4)
COMP1: CCOMP13.2, PS2.46 (COMP1), RCOMP5.1
COMP2: CCOMP5.1, PS2.15 (COMP2), RCOMP6.2
COMP3: CCOMP7.1, PS2.25 (COMP3), RCOMP7.2
COMP4: CCOMP10.1, PS2.36 (COMP4), RCOMP8.1
CS: IC3.22 (NCS), U1.11 (IO26)
EN: C28.1, R31.1, R38.2, U1.3 (EN)
FANPWM: IC9.3 (GND), J8.1, R36.1
FANPWM/TMS: J3.1, J8.2, U1.13 (IO14)
FSYNC: IC3.11 (FSYNC)
F_RECEIVER: Q1.2 (E), R14.2, U1.20 (CLK)
GND: C2.2, C3.2, C4.2, C5.2, C6.2, C7.2, C8.1, C9.2, C10.2, C11.2, C12.2, C13.2, C14.2, C15.2, C16.2, C17.2, C18.2, C19.2, C20.2, C21.2, C22.2, C23.2, C24.2, C25.2, C26.2, C27.2, C28.2, C29.2, C30.2, C31.2, C32.2, C33.2, C34.2, C35.2, C36.2, C37.2, C38.2, C39.2, C40.2, C43.1, C44.1, C45.2, C46.2, C47.2, C48.2, C49.2, C50.2, CCOMP5.2, CCOMP6.2, CCOMP7.2, CCOMP8.1, CCOMP9.1, CCOMP10.2, CCOMP11.1, CCOMP13.1, CIN1.2, CIN2.2, CIN3.2, COUT1.2, COUT5.2, COUT6.1, CSS5.2, CSS6.2, CSS7.2, CSS8.1, CVDD1.2, CVDDA1.1, CVDDG1.2, IC1.11 (NC_1), IC1.12 (NC_2), IC1.20 (AGND), IC1.21 (PGND), IC3.18 (GND), IC3.25 (PAD), IC6.3 (GND), IC8.3 (GND), IC9.4 (INB), J2.P$2, J5.4, J6.4, PB1.1, PB2.1, PS2.7 (PGND1), PS2.8 (PGND2), PS2.21 (AGND), PS2.49 (PGND), Q10.3 (N1S/N2S), Q11.3 (N1S/N2S), R1.1, R6.1, R8.1, R9.1, R11.1, R13.1, R14.1, R15.1, R16.1, R17.1, R18.1, R19.1, R20.1, R23.1, R24.1, R26.1, R45.1, RFBB5.1, RFBB6.1, RFBB7.2, RFBB8.1, ROSC1.1, RPMU7.2, T1.1 (S), T1.2 (S), T1.3 (S), T2.2 (E), T3.2 (E), T4.S, T5.S, T6.S, T7.S, T8.S, U1.1 (GND), U1.15 (GND), U1.38 (GND), U1.GND, U$8.1 (NC_1), U$8.8 (VSS), U$8.10 (BS0), U$8.12 (BS2), U$8.13 (CS#), U$8.16 (R/W#), U$8.17 (E/RD#), U$8.21 (D3), U$8.22 (D4), U$8.23 (D5), U$8.24 (D6), U$8.25 (D7), U$8.29 (VLSS), U$8.30 (NC_3), UART.2
I2CADDR: PS2.38 (I2CADDR), RPMU7.1
I2CALERT: PS2.41 (I2CALERT), RPMU8.1
INT: IC3.12 (INT)
IO0: R22.1, R37.2, U1.25 (IO0)
IO2: R23.2, U1.24 (IO2)
LF_EMITTER/TCK: JTAG.2, R11.2, T5.G, U1.16 (IO13)
LF_RECEIVER: Q4.2 (E), R17.2, U1.26 (IO4)
LPWMA: IC8.2 (INA), R52.1, U1.31 (IO19)
LPWMB: IC8.4 (INB), R53.1, U1.30 (IO18)
L_EMITTER: R8.2, T4.G, U1.36 (IO22)
L_ENC_A: J6.1, U1.5 (SENSOR_VN)
L_ENC_B: J6.2, U1.4 (SENSOR_VP)
L_RECEIVER1: Q2.2 (E), R15.2, U1.22 (SD1)
L_RECEIVER2: Q3.2 (E), R16.2, U1.21 (SDO)
M_EMITTER/TDO: JTAG.1, R13.2, T6.G, U1.23 (IO15)
N1D: J5.5, Q10.2 (N1D/P1D)
N1D_2: J6.5, Q11.2 (N1D/P1D)
N1G: IC6.7 (OUTA), Q10.1 (N1G), Q10.8 (P1G)
N1G_2: IC8.7 (OUTA), Q11.1 (N1G), Q11.8 (P1G)
N2D: J5.6, Q10.6 (N2D/P2D)
N2D_2: J6.6, Q11.6 (N2D/P2D)
N2G: IC6.5 (OUTB), Q10.4 (N2G), Q10.5 (P2G)
N2G_2: IC8.5 (OUTB), Q11.4 (N2G), Q11.5 (P2G)
unnamed: C5.1, IC1.18 (COMP), R21.2
unnamed: C1.1, IC1.8 (BOOT)
unnamed: C1.2, IC1.4 (SW_1), IC1.5 (SW_2), IC1.6 (SW_3), IC1.7 (SW_4), R27.2, U$9.P$2 (2)
unnamed: C48.1, IC1.1 (VCC)
unnamed: C47.1, IC1.10 (SS)
unnamed: R46.2, T2.1 (B)
unnamed: LED5.1 (K), LED7.2 (A)
unnamed: IC1.19 (ILIM), R26.2
unnamed: C2.1, R21.1
unnamed: LED1.1 (K), R4.2
unnamed: R4.1, T8.D
unnamed: LED7.1 (K), R12.2
unnamed: LED2.1 (K), R5.2
unnamed: R5.1, T4.D
unnamed: R12.1, T6.D
unnamed: C43.2, PB1.2, R37.1
unnamed: LED3.1 (K), R7.2
unnamed: R7.1, T7.D
unnamed: IC9.6 (VDD), T1.4 (G)
unnamed: IC1.17 (FB), R24.2, R25.1
unnamed: D6.2 (A), J7.P$2, T1.MB (D)
unnamed: LED4.1 (K), R10.2
unnamed: R10.1, T5.D
unnamed: IC1.3 (FSW), R27.1
unnamed: C44.2, PB2.2, R38.1
unnamed: PLZ6V2B-G3/H.A, R45.2, R46.1
unnamed: R47.1, R48.1, T2.3 (C)
unnamed: R47.2, T3.1 (B)
unnamed: D3.C, R48.2
unnamed: C42.1, U$8.2 (C2P)
unnamed: D5.C, R49.2
unnamed: R49.1, T3.3 (C)
unnamed: C42.2, U$8.3 (C2N)
unnamed: C41.1, U$8.4 (C1P)
unnamed: C41.2, U$8.5 (C1N)
unnamed: C40.1, U$8.27 (VCOMH)
unnamed: C7.1, U$8.28 (VCC)
unnamed: D4.2 (A), R35.1, U$8.14 (RES#)
unnamed: R1.2, U$8.26 (IREF)
unnamed: CCOMP6.1, RCOMP7.1
unnamed: CCOMP8.2, RCOMP6.1
unnamed: CCOMP9.2, RCOMP8.2
unnamed: CCOMP11.2, RCOMP5.2
NC: U1.32 (NC)
OUT1: CBST1.2, L7.2, PS2.2 (SW1_1), PS2.3 (SW1_2), PS2.4 (SW1_3)
OUT2: CBST2.2, L5.2, PS2.9 (SW2_1), PS2.10 (SW2_2), PS2.11 (SW2_3)
OUT3: CBST3.1, L8.1, PS2.29 (SW3)
OUT4: CBST4.1, L6.1, PS2.32 (SW4)
PGOOD: PS2.17 (PGOOD), RPMU12.1
RCLOCK: PS2.40 (RCLOCK), ROSC1.2
REGOUT: C31.1, IC3.10 (REGOUT)
RF_EMITTER: R6.2, T8.G, U1.28 (IO17)
RF_RECEIVER: Q7.2 (E), R20.2, U1.17 (SD2)
RPWMA: IC6.2 (INA), R29.1, U1.27 (IO16)
RPWMB: IC6.4 (INB), R30.1, U1.29 (IO5)
RST_N: PS2.39 (RST_N), RPMU9.1
RXD: U1.34 (RXD0), UART.3
R_EMITTER: R9.2, T7.G, U1.33 (IO21)
R_ENC_A: J5.1, U1.7 (IO35)
R_ENC_B: J5.2, U1.6 (IO34)
R_RECEIVER1: Q5.2 (E), R18.2, U1.18 (SD3)
R_RECEIVER2: Q6.2 (E), R19.2, U1.19 (CMD)
SCL: R2.1, U1.12 (IO27), U$8.18 (D0)
SCLK: IC3.23 (SCL/SCLK), U1.10 (IO25)
SCLPMU: PS2.43 (SCL), RPMU11.1
SDA: R3.1, U1.37 (IO23), U$8.19 (D1), U$8.20 (D2)
SDAPMU: PS2.42 (SDA), RPMU10.1
SDI: IC3.24 (SDA/SDI), U1.9 (IO33)
SDO: IC3.9 (SDO/AD0), U1.8 (IO32)
SS1: CSS8.2, PS2.45 (SS1/PG1)
SS2: CSS5.1, PS2.16 (SS2/PG2)
SS3: CSS6.1, PS2.24 (SS3/PG3)
SS4: CSS7.1, PS2.37 (SS4/PG4)
TDI: J3.2, U1.14 (IO12)
TXD: U1.35 (TXD0), UART.4
VBATT: C6.1, C8.2, C45.1, CIN1.1, CIN2.1, D3.A, D5.A, IC1.9 (VBN), J2.P$1, PLZ6V2B-G3/H.K, PS2.5 (PVIN1), PS2.6 (PVIN2), PS2.22 (VIN), PS2.30 (PVIN3), PS2.31 (PVIN4), U$9.P$1 (1)
VBOOST: C33.1, C34.1, C35.1, C36.1, C37.1, C38.1, C46.1, C49.1, C50.1, IC1.14 (VOUT_1), IC1.15 (VOUT_2), IC1.16 (VOUT_3), IC6.6 (VDD), IC8.6 (VDD), IC9.5 (OUTB), Q10.7 (P1S/P2S), Q11.7 (P1S/P2S), R25.2
VDDA: CVDDA1.2, PS2.19 (VDDA)
VDDD: CVDD1.1, PS2.13 (ENSW2), PS2.20 (VDDD), PS2.27 (ENSW3), PS2.34 (ENSW4), PS2.48 (ENS1), RPMU8.2, RPMU9.2, RPMU10.2, RPMU11.2, RPMU12.2
VDDG: CVDDG1.1, PS2.18 (VDDG)
VFB1: PS2.47 (VFB1), RFBB8.2, RFBT6.1
VFB2: PS2.14 (VFB2), RFBB5.2, RFTB5.1
VFB3: PS2.26 (VFB3), RFBB6.2, RFBT8.1
VFB4: PS2.35 (VFB4), RFBB7.1, RFBT5.2

Notes on the sheet:
IR Emitter System
IR Receiver System
IO0/IO2 pulled up/down correctly by default. Resistor pad included just in case.
ESP32 MCU Module
Serial Connectors
Gyroscope
Motor Control
Ground Effect Fan
OLED Display
Battery Connection
Motor 12V Boost
Low Battery Indicator
Power Management Unit
PMU_Ch1: 5V 4.0A - Fan Supply PMU_Ch2: 5V 3.0A - 2 IR LEDs, Status LEDs PMU_Ch3: 2V 2.0A - 4 IR LEDs PMU_Ch4: 3.3V 0.5A - MCU, OLED, gyro

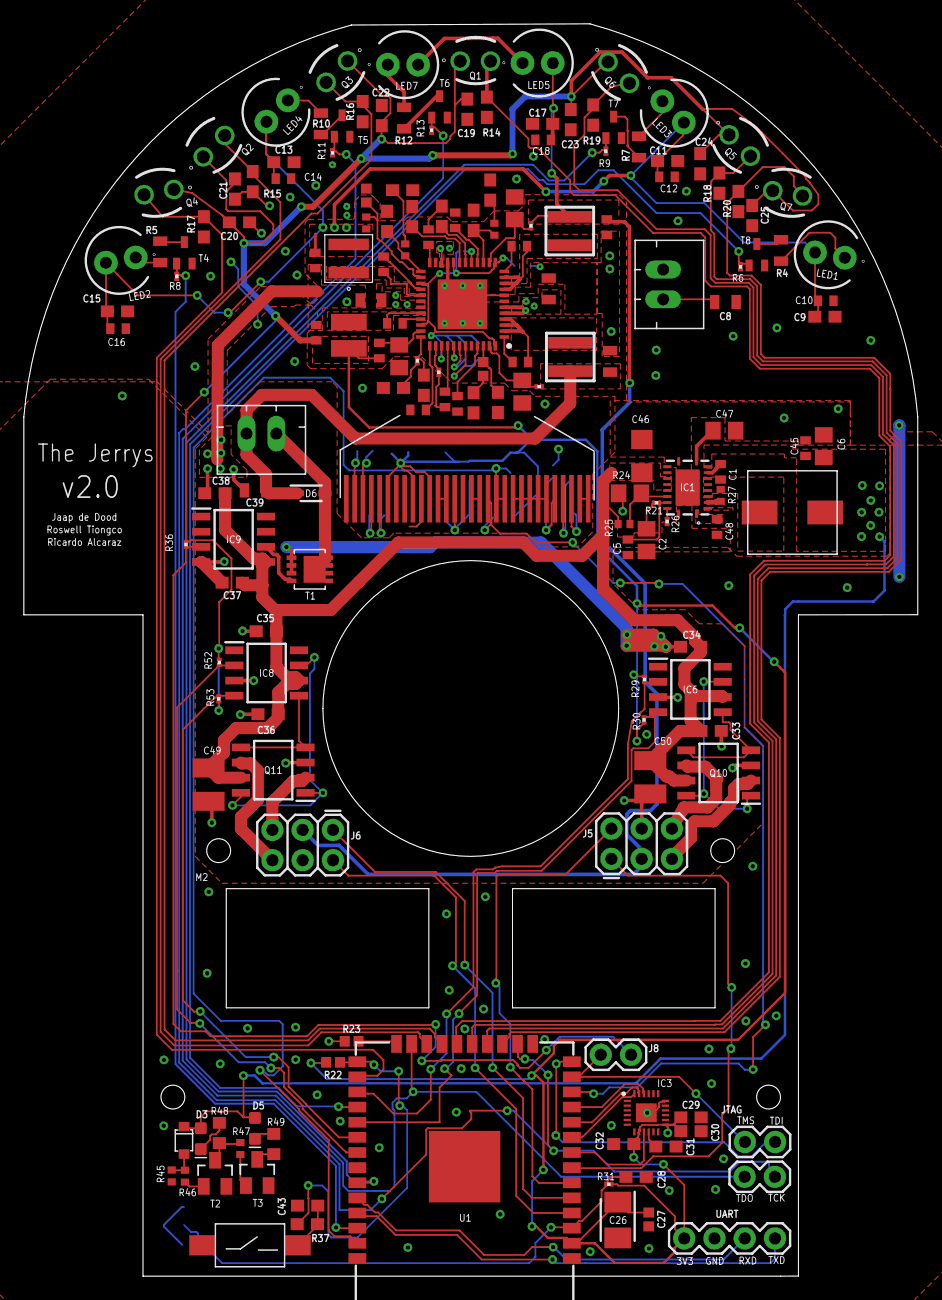
[picture p9: board boardv3.brd from above]

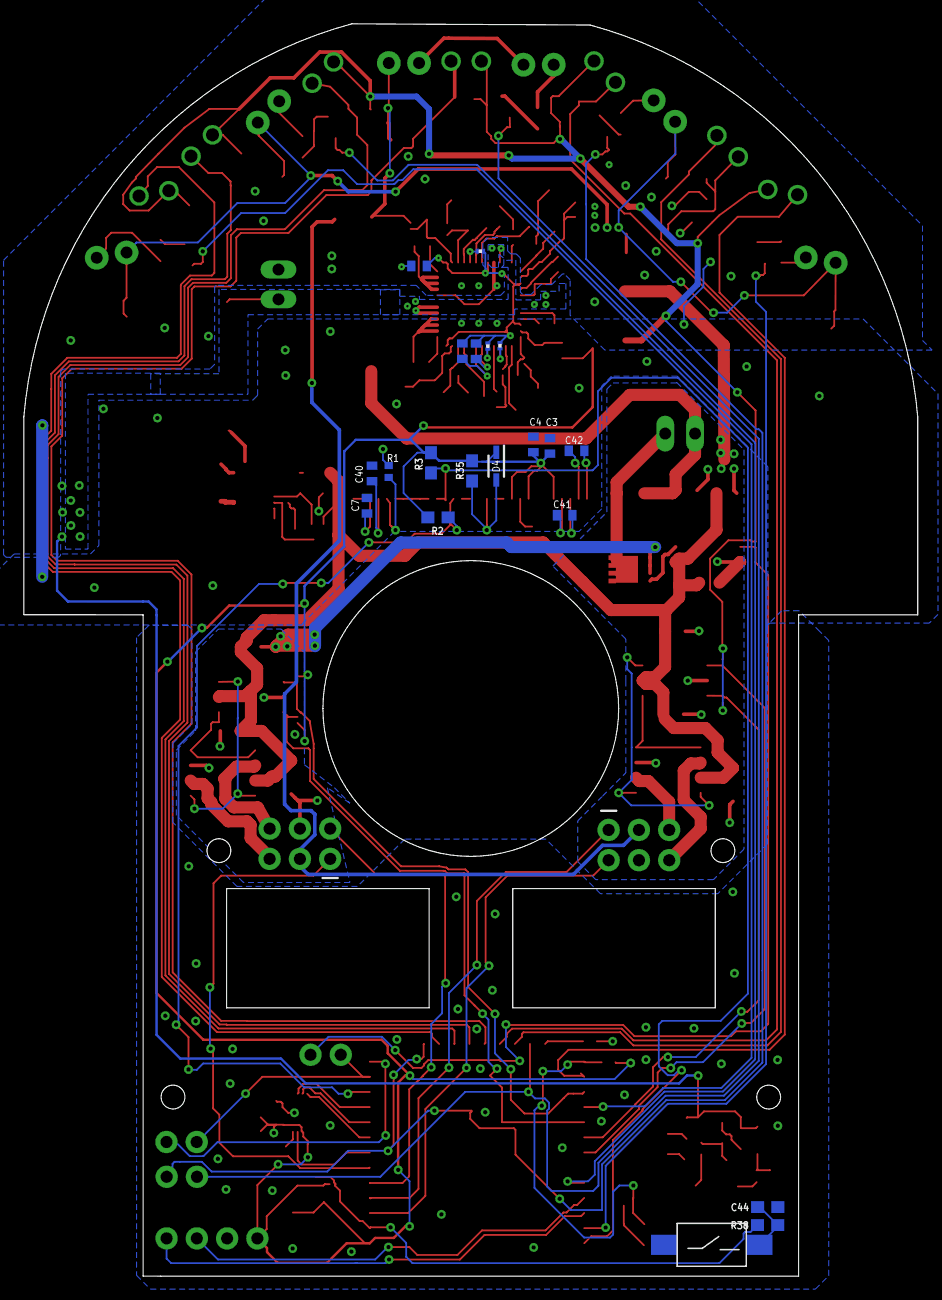
[picture p10: board boardv3.brd from below]

Board: 2 copper layers, 75.0 x 105.1 mm, 186 parts (20 on the bottom side), 123 nets.
