ricardoalcaraz/TheJerrys/eagle_v1/board_v1.brd

## EAGLE design eagle_v1/board_v1.brd (2017-07-20, an earlier design)

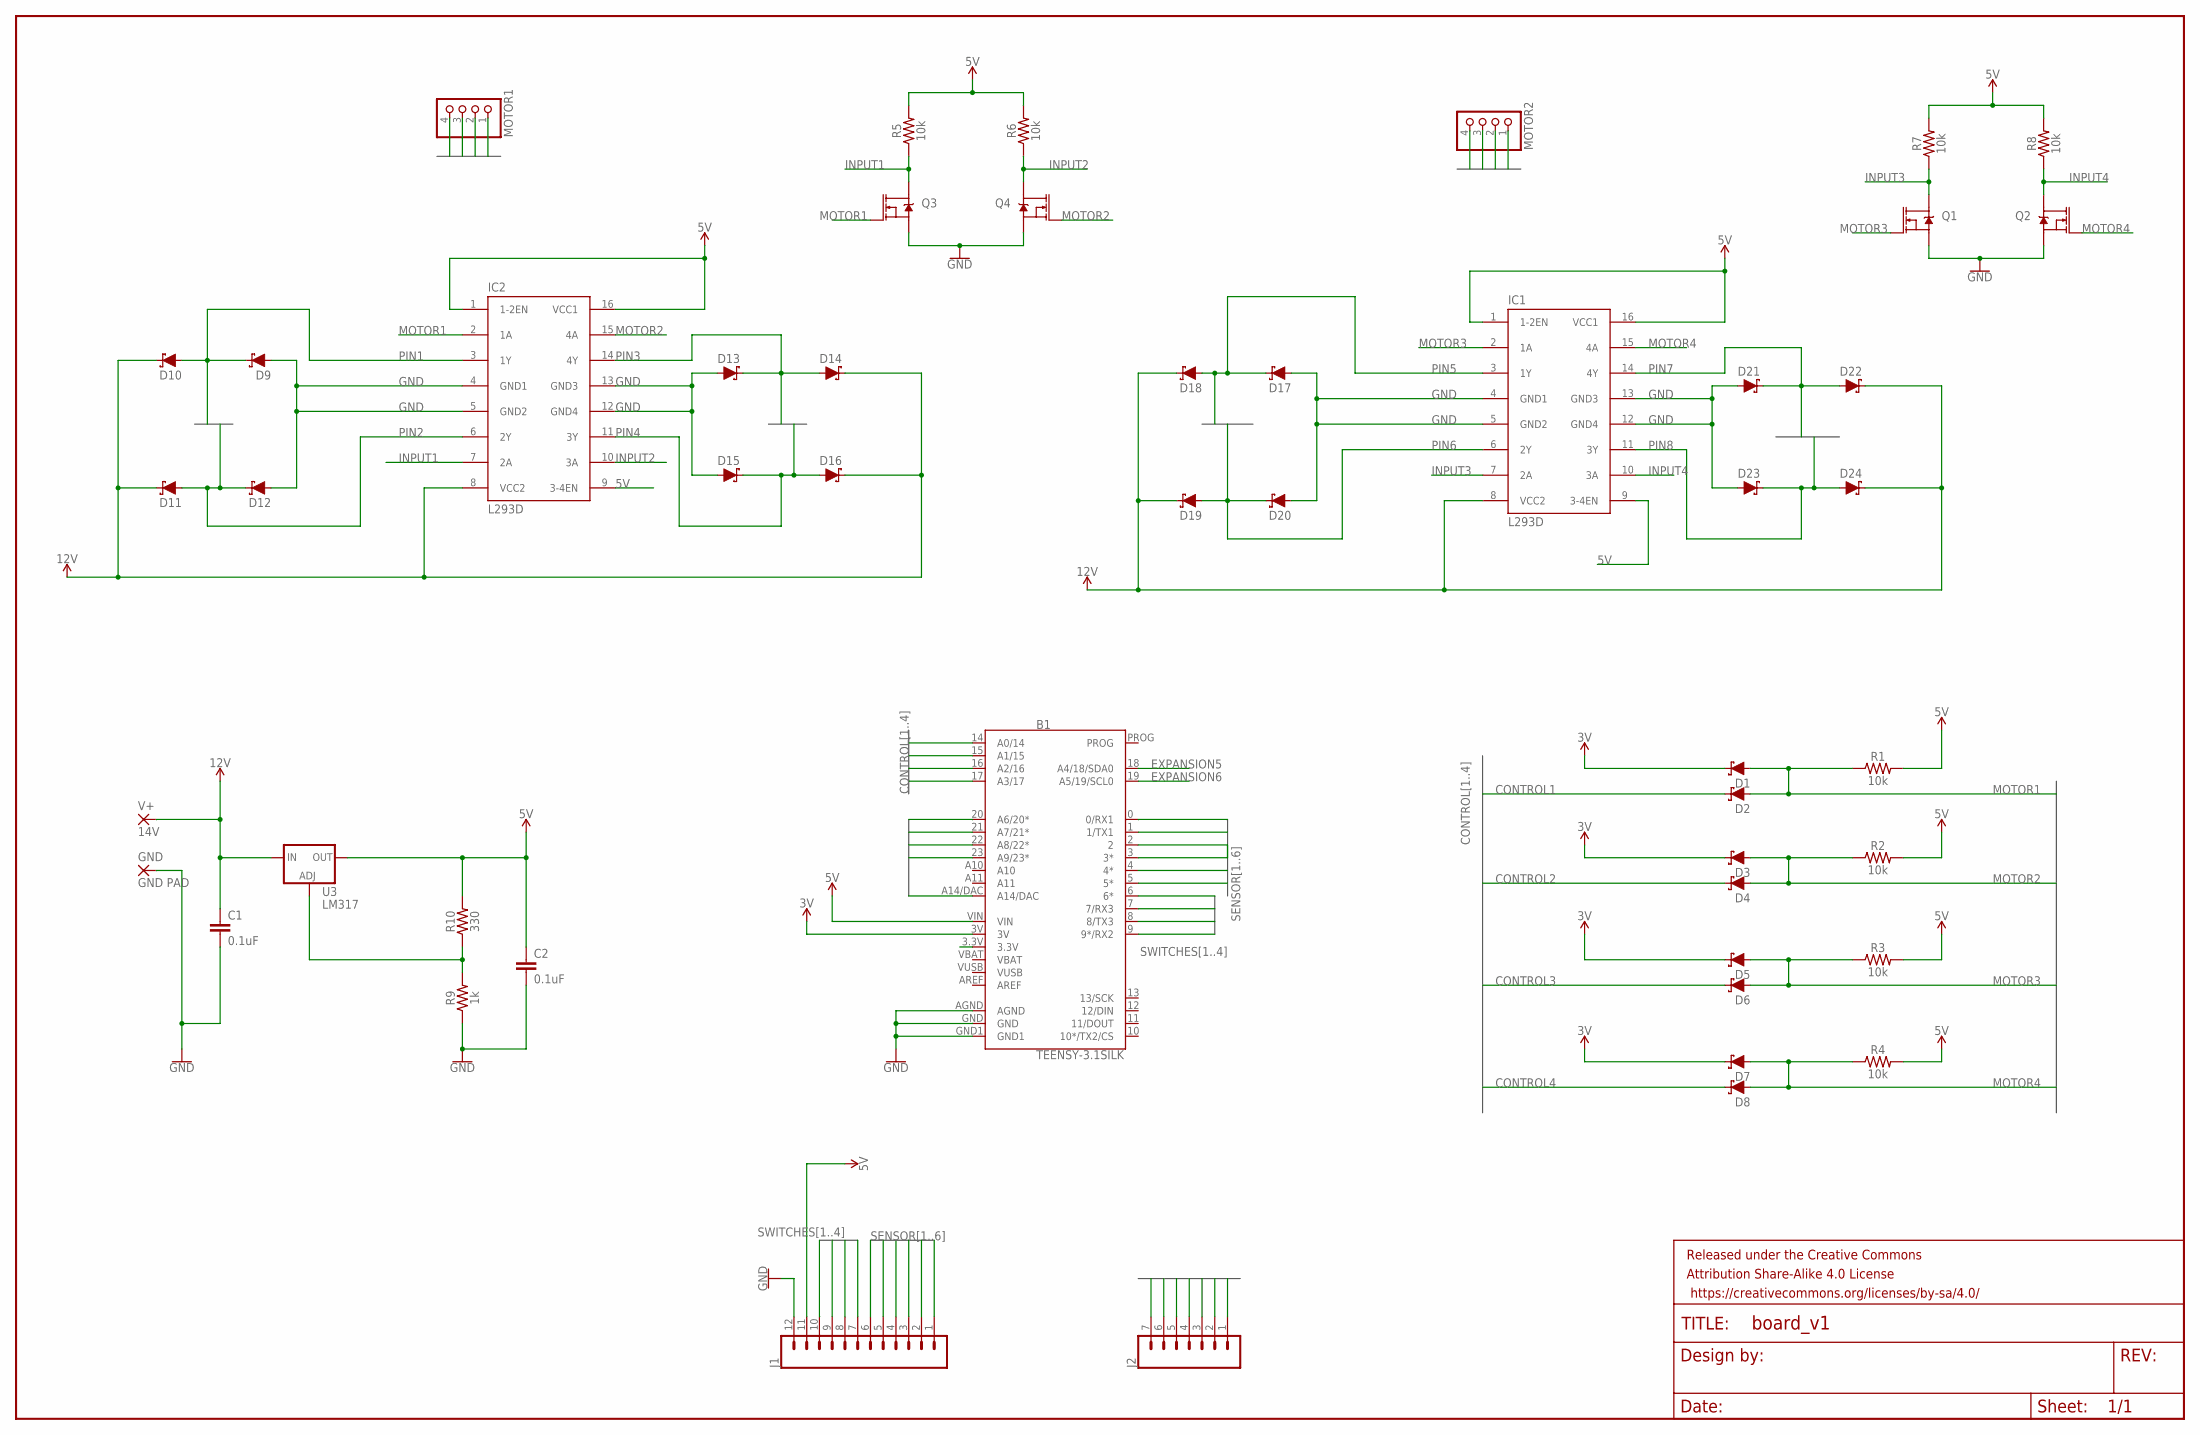
[picture p11: schematic board_v1.sch]

Parts:
B1: TEENSY-3.1SILK; TEENSY-3.1
C1, C2: 0.1uF; 0603
D1, D2, D3, D4, D5, D6, D7, D8, D9, D10, D11, D12, D13, D14, D15, D16, D17, D18, D19, D20, D21, D22, D23, D24: DIODE-SCHOTTKY-PMEG4005EJ; SOD-323
FRAME1: FRAME-LEDGER; CREATIVE_COMMONS
GND: GND PAD; SMD2,54-5,08
IC1, IC2: L293D; DIL16
J1: CONN_12; 1X12
J2: CONN_07LOCK; 1X07_LOCK
MOTOR1, MOTOR2: PINHD-1X4; 1X04
Q1, Q2, Q3, Q4: MOSFET-NCH-2N7002PW; SOT323
R1, R2, R3, R4, R5, R6, R7, R8: 10k; 0603
R9: 1k; 0603
R10: 330; 0603
U3: LM317; TO220-ADJ
V+: 14V; SMD2,54-5,08

Connections:
3.3V: B1.3V, D1.C, D3.C, D5.C, D7.C
5V: B1.VIN, C2.1, IC1.1 (1-2EN), IC1.9 (3-4EN), IC1.16 (VCC1), IC2.1 (1-2EN), IC2.9 (3-4EN), IC2.16 (VCC1), J1.11, R1.2, R2.2, R3.2, R4.2, R5.2, R6.2, R7.2, R8.2, R10.2, U3.OUT
12V: C1.1, D10.C, D11.C, D14.C, D16.C, D18.C, D19.C, D22.C, D24.C, IC1.8 (VCC2), IC2.8 (VCC2), U3.IN, V+.1
CONTROL1: B1.17 (A3/17), D2.C
CONTROL2: B1.16 (A2/16), D4.C
CONTROL3: B1.15 (A1/15), D6.C
CONTROL4: B1.14 (A0/14), D8.C
EXPANSION1: B1.20 (A6/20*), J2.1
EXPANSION2: B1.21 (A7/21*), J2.2
EXPANSION3: B1.22 (A8/22*), J2.3
EXPANSION4: B1.23 (A9/23*), J2.4
EXPANSION5: B1.18 (A4/18/SDA0), J2.5
EXPANSION6: B1.19 (A5/19/SCL0), J2.6
EXPANSION7: B1.A14/DAC, J2.7
GND: B1.AGND, B1.GND, B1.GND1, C1.2, C2.2, D9.A, D12.A, D13.A, D15.A, D17.A, D20.A, D21.A, D23.A, GND.1, IC1.4 (GND1), IC1.5 (GND2), IC1.12 (GND4), IC1.13 (GND3), IC2.4 (GND1), IC2.5 (GND2), IC2.12 (GND4), IC2.13 (GND3), J1.12, Q1.2 (S), Q2.2 (S), Q3.2 (S), Q4.2 (S), R9.1
INPUT1: IC2.7 (2A), Q3.3 (D), R5.1
INPUT2: IC2.10 (3A), Q4.3 (D), R6.1
INPUT3: IC1.7 (2A), Q1.3 (D), R7.1
INPUT4: IC1.10 (3A), Q2.3 (D), R8.1
MOTOR1: D1.A, D2.A, IC2.2 (1A), Q3.1 (G), R1.1
MOTOR2: D3.A, D4.A, IC2.15 (4A), Q4.1 (G), R2.1
MOTOR3: D5.A, D6.A, IC1.2 (1A), Q1.1 (G), R3.1
MOTOR4: D7.A, D8.A, IC1.15 (4A), Q2.1 (G), R4.1
unnamed: R9.2, R10.1, U3.ADJ
PIN1: D9.C, D10.A, IC2.3 (1Y), MOTOR1.4
PIN2: D11.A, D12.C, IC2.6 (2Y), MOTOR1.3
PIN3: D13.C, D14.A, IC2.14 (4Y), MOTOR1.2
PIN4: D15.C, D16.A, IC2.11 (3Y), MOTOR1.1
PIN5: D17.C, D18.A, IC1.3 (1Y), MOTOR2.4
PIN6: D19.A, D20.C, IC1.6 (2Y), MOTOR2.3
PIN7: D21.C, D22.A, IC1.14 (4Y), MOTOR2.2
PIN8: D23.C, D24.A, IC1.11 (3Y), MOTOR2.1
SENSOR1: B1.0 (0/RX1), J1.1
SENSOR2: B1.1 (1/TX1), J1.2
SENSOR3: B1.2, J1.3
SENSOR4: B1.3 (3*), J1.4
SENSOR5: B1.4 (4*), J1.5
SENSOR6: B1.5 (5*), J1.6
SWITCHES1: B1.6 (6*), J1.7
SWITCHES2: B1.7 (7/RX3), J1.8
SWITCHES3: B1.8 (8/TX3), J1.9
SWITCHES4: B1.9 (9*/RX2), J1.10
VBAT: B1.VBAT
VUSB: B1.VUSB

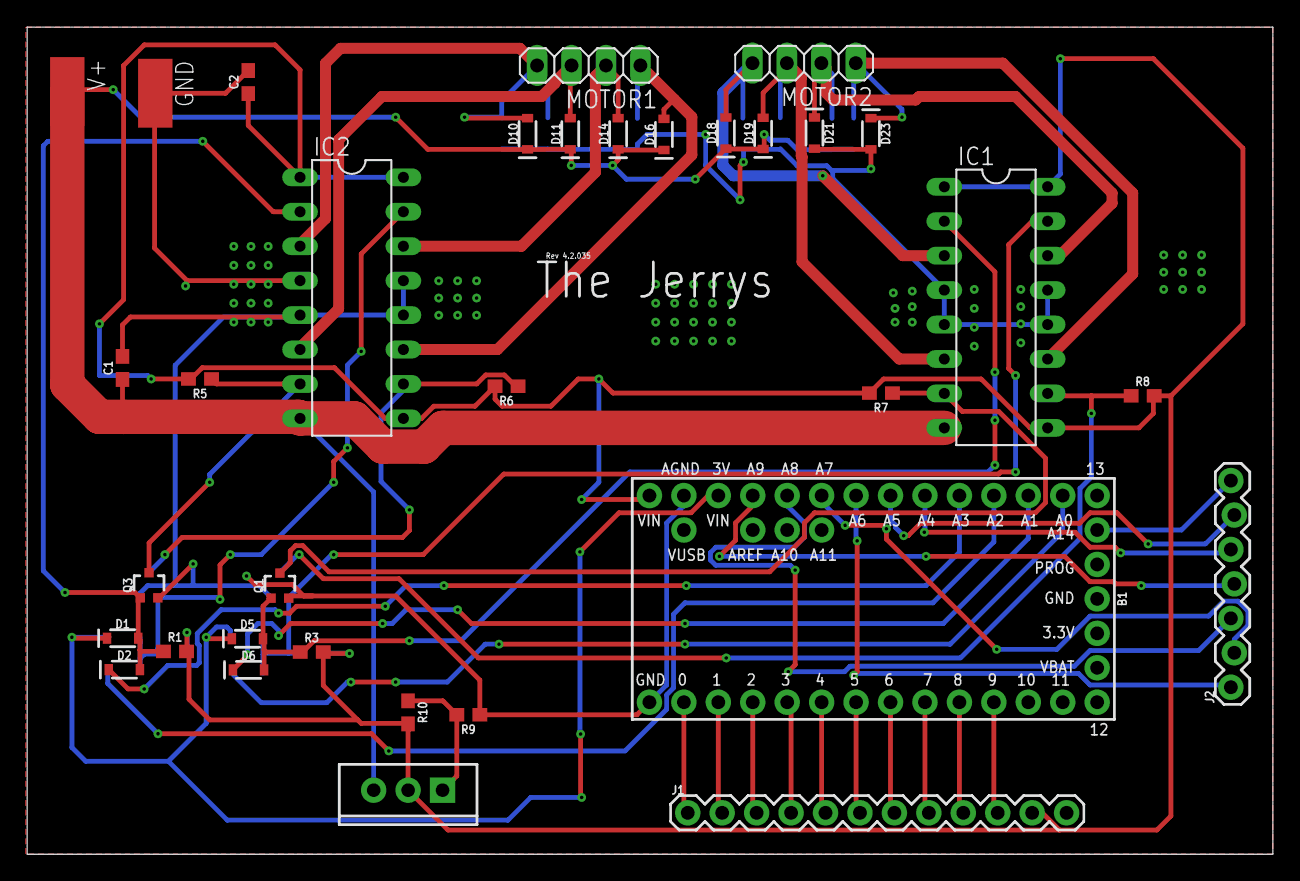
[picture p12: board board_v1.brd from above]

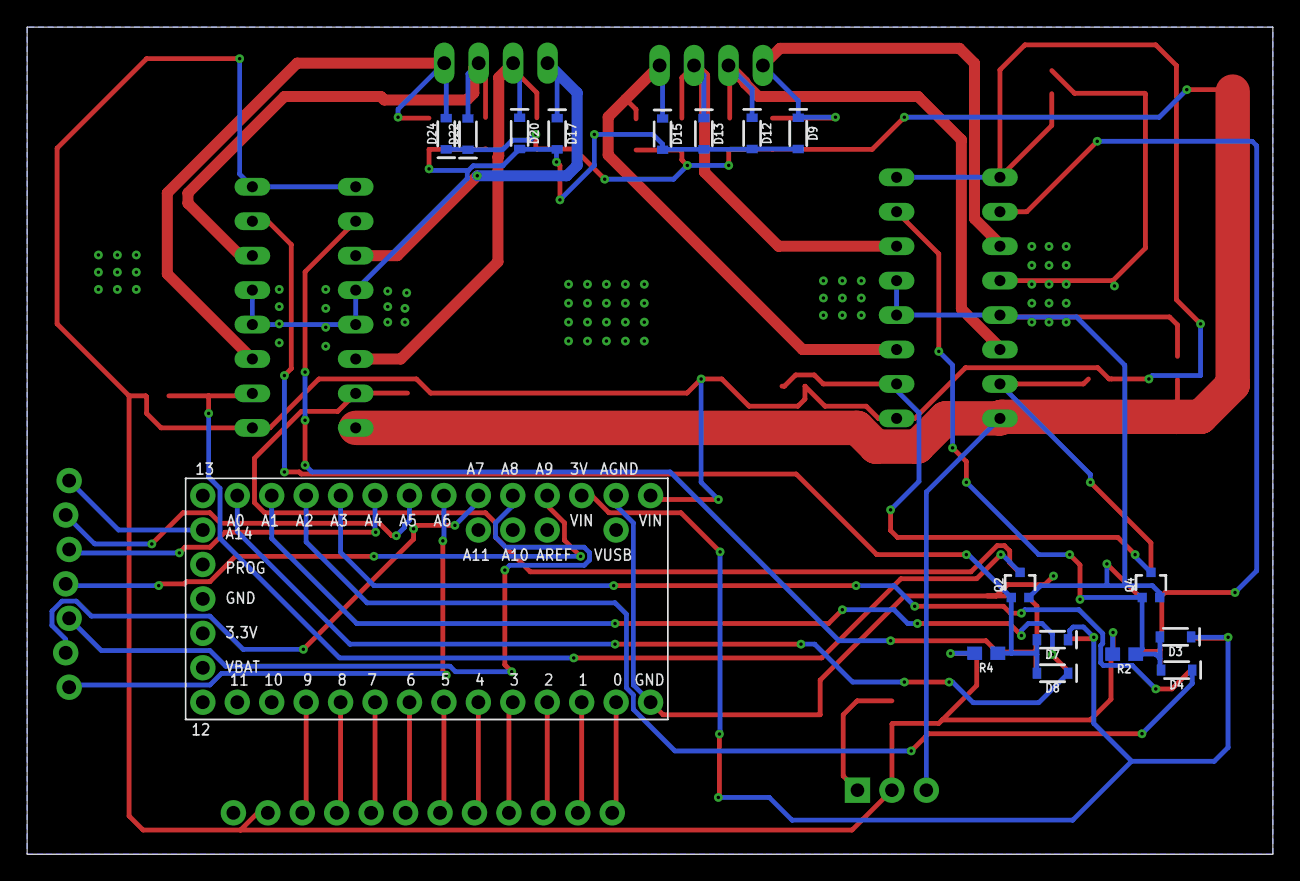
[picture p13: board board_v1.brd from below]

Board: 2 copper layers, 91.9 x 61.0 mm, 51 parts (16 on the bottom side), 42 nets.
