ricardoalcaraz/TheJerrys/(commit log)

2017-06-12 Added new schematic and board
    [BlazeIt.sch, micromouse_v35.brd, micromouse_v35.sch]
2017-06-12 added motor control wiring
    [BlazeIt.sch]
2017-06-12 Added sensor pins
    [BlazeIt.sch]
2017-06-12 Added sensor pins to schematic
    [BlazeIt.sch]
2017-06-12 Finished Schematic Draft
    [BlazeIt.brd, BlazeIt.sch]
2017-06-12 Fixed some inconsistencies
    [BlazeIt.brd, BlazeIt.sch]
2017-07-20 Finalized Design
    [BlazeIt.brd, BlazeIt.sch]
2017-07-20 Final final design
    [BlazeIt.brd, BlazeIt.sch]
2017-07-20 Added ultrasonic sensor functions
2017-07-20 Added stepper motor + H bridge comm file that draws 0 current when inactive
2017-07-21 Fixed ability to read distances in serial monitor
    Added Serial.begin(9600) in order to initiate ability to read. Prior to this, sensor worked, but user could not read an output to confirm sensor's working ability. Additionally shifted delay after checking distance at the end of all three pulses instead of after just the right. Doing so makes the distances output at a similar time instead of feeling choppy when sandwhiched in between pulseRight and pulseLeft. Changed delay to 100 ms instead of 1000ms as a 1 second refresh rate felt to sluggish whereas not having any delay produces too much data too quickly.
2017-07-21 Changed pulseMiddle() function to be able to output a distance
    pulseMiddle() used to just record and print distance. After changing its void return type to an int, it can now be treated as a variable and spit out a distance in cm. This will make it easier to engage the motor when the sensor senses no wall.
2017-07-21 Replicated changes from pulseMiddle() to pulseRight() and pulseLeft()
    Lets user know when mouse can turn to make it easier to exxecute a turn. NOTE: if a single sensor gets very blocked as it nears an opening, measurements become really off and reach 3000cm. Since the actions are triggered in an if statements if only needs to happen once to mess everything up. Some ways to circumvent this is to have the if statement execute given a range rather than a single value comparison. Furthermore depending on the stepper motor speed the pulse rate can be played with to prevent this from happening.
2017-07-21 Added file that combines sensor and motor
    Lets motor turn when sensor senses a gap. Still expends no current.
2017-07-21 Limit distance on sensors
    By setting the maximum time the sensor waits for a pulse, we can limit the maximum distance the pulse records. In this case, the sensor has been limited to 80cm.
2017-07-21 Updated combined sensor and motors to implement sensor range limitation
2017-07-22 Wrote code to implement a second motor
    Duplicated code and reassigned variable names. Cars will rotate on axis instead of pivoting. Therefore motor turning functions have both motors work at same time instead of having independent turning functions. Additionally, step size incrementation variable has been included for ease of tinkering. Will debug later as I do not have access to a second motor at the moment.
2017-07-22 Added actual pin assignment for motors to the prototype board pin assignment
    Just comment out the prototype board/actual as necessary.
2017-07-25 Added switch functionality
    Using four switches in a case select scenario, we can 16 different possible outputs.
2017-07-25 Added new stepper library and functions
2017-07-27 Edited code variables and included convenience delay
    Renamed motor pins to be motorLeft and motorRight instead of motor1 and motor 2. Additionally, there will be a delay after we flick the switch before the mouse starts working.
2017-07-27 Changed moveLeft and moveRight functions
    moveleft and move right no longer spin on its axis. It now pivots with one wheel stationary and the other incrementing steps. The functions are now named turnLeft() and turnRight(). Also removed the moveforward() function that gets called whenever the mouse turns as the mouse should move forward by default after turning.
2017-07-29 Begun adding ultrasonic sensor functions
    Only added basic pin assignments and setup
2017-07-29 Fixed some compilation errors
    [Jerry.cpp]
2017-07-29 added debug print statements
2017-07-29 Fixed pathing logic and started fine tuning movements
    [Jerry.cpp]
2017-07-29 Added path correcting to library
    [Jerry.cpp, Stepper.cpp]
2017-07-29 Added path correction and minor micromouse.ino files
    [Jerry.cpp, Stepper.cpp]
2017-07-29 Deleted jerry and stepper libraries as they should be in same folder level as main micromouse.ino
2017-07-29 Revert "Deleted jerry and stepper libraries as they should be in same folder level as main micromouse.ino"
    This reverts commit 5623b765bdf1a9f3894e21da4fe20d62e673050c.
    [Jerry.cpp, Stepper.cpp]
2017-08-24 Fixed various compilation errors
    [Jerry.cpp]
2018-01-25 Polished board and added names
    [MicroMouseBoardV2.brd, MicroMouseBoardV2.sch]
2018-03-12 Started 2018 board revision for micromouse
    [MicroMouseBoardV2.brd, MicroMouseBoardV2.sch, micromouse2018_v1.brd, micromouse2018_v1.sch, micromouse_v35.brd, micromouse_v35.sch]
2018-03-12 Added power switch to schematic
    [micromouse2018_v1.brd, micromouse2018_v1.sch]
2018-03-20 Added power circuit
    [micromouse2018_v1.brd, micromouse2018_v1.sch]
2018-03-21 Changed SS31FL diode to CMS06 for better heat dissipation
    [micromouse2018_v1.brd, micromouse2018_v1.sch]
2018-03-22 Rough draft for 5V power circuit layout
    [micromouse2018_v1.brd, micromouse2018_v1.sch]
2018-03-25 Created 12V layout, removed thermals on 5V layout
    [micromouse2018_v1.brd, micromouse2018_v1.sch]
2018-03-28 Completed Board layout, passed DRC, removed 2 status LEDs, increased C6 C7
    [micromouse2018_v1.brd, micromouse2018_v1.sch]
2018-04-03 Fixed some silkscreen labels
    [micromouse2018_v1.brd, micromouse2018_v1.sch]
2018-04-04 Made mounting holes a bit smaller
    [micromouse2018_v1.brd, micromouse2018_v1.sch]
2018-05-22 Added some more functions to the motors class
2018-05-22 Added some changes to motor functions
2018-05-25 Fixed all motor turning functions
    [MicroMouse_Code_2018.ino, Motors.cpp, Motors.h]
2018-05-25 Added a turn around feature, perfected motor functions and added code documentation
2018-05-25 Fixed interference issues with sensors
    [Sensors.cpp]
2018-05-26 Added more motor movement functions
2018-06-06 Added motor functions
    [micromouse2018_v1.brd, micromouse2018_v1.sch]
2018-06-08 Major motor rework: changed ricardo's code
    [MicroMouse_Code_2018.ino, Motors.cpp, Motors.h]
2018-06-09 Created new Motor headers
2018-06-10 PID controller for lanekeeping
2018-06-10 Changed motor millisecond delay to microsecond delay for PID
2018-06-10 Tuned PID and included UTURN
2018-06-14 Tuned PID, modified main loop to make robot solve maze by crashing into walls
    [MicroMouse_Code_2018.ino]
2018-06-14 callibrated auto forward pid to go to the middle of the cell for intersections
2018-06-17 Reverted sensor and updated pid system
    [MicroMouse_Code_2018.ino, Sensors.cpp, Sensors.h]
2018-06-17 Worked on PID
2018-06-17 Tuned pid
2018-06-19 Changed pid values to consistently work in hallways and uturn
    Tested hallway/uturn to work for 2+mins
2018-06-27 Fixed autoForward centering callibration. Had fairly consistent straights and cornering prior to hardware blowing up
    [MicroMouse_Code_2018.ino, Motors.cpp]
2018-07-19 2019 update
    [MicroMouseBoardV2.brd, MicroMouseBoardV2.sch, micromouse2018_v1.brd, micromouse2018_v1.sch, micromouse_v35.brd, micromouse_v35.sch, micromousev2.brd, micromousev2.sch]
2018-07-19 2019 update second commit
    [MicroMouseBoardV2.brd, MicroMouseBoardV2.sch, micromouse2018_v1.brd, micromouse2018_v1.sch, micromouse_v35.brd, micromouse_v35.sch]
2018-07-19 cleaned up dir names
    [MicroMouseBoardV2.brd, MicroMouseBoardV2.sch, micromouse2018_v1.brd, micromouse2018_v1.sch, micromouse_v35.brd, micromouse_v35.sch]
2018-07-19 Added initWalls() and made printMaze() read from cell[][]
2019-03-02 Altium Schematic
    [Communications.SchDoc, MCU.SchDoc, Micromouse_Altium_v4.PcbDoc, Micromouse_Altium_v4.SchDoc, Motors.SchDoc, Power.SchDoc, Sensors.SchDoc, altium_v4.PrjPCB]
